apc53pro/Nano-20K-GPU/docs/images/current-gpu-pipeline.pdf

# Current GPU model — shared-reciprocal textured pipeline N20K-SYS-0.1 — host, ordered execution, shared SDRAM and independent scanout

Host CPU / driver — outside simulated GPU execution time

### Current device model — one common 100.8 MHz core / SDR clock (configured assumption)

Clocked host interface — no direct C++ pass injection

Ordered executor — exactly one command operation active; branches are alternatives

Shared memory subsystem — six bounded client ports, one physical SDR data bus

Independent scanout — continues while the ordered executor renders or waits

Transform and homogeneous clipping Projection / Q4 triangle setup / lighting Stable bins for 300 logical 32×32 tiles

HostPassCompiler / CPU packet encoder Persistent images + 320-byte prepared records Tile table + ordered address lists Upload new/changed textures + transient heap Typical stream: WRITE_HEAP, SUBMIT_PASS, then separate FENCE and PRESENT commands prepared commands and pixels

Shared 8-bit parallel bus
25.2 MHz derived transfer cadence ≤1 byte / 4 core edges, one direction Setup 1 / hold 1 core cycle Register select + valid/read/ready

serialized request bytes

RX FIFO: 256 bytes
1 × SDPB 1024×16
Low byte per native word

accepted write byte

Sideband reads bypass command queue Regs 1–63: coherent status snapshot Regs 64–127: immutable capabilities Status remains readable during faults

read selector

Out-of-band abort / reset
Abort: quiesce, drain issued memory, flush queues, new epoch
Reset: restart initialization

out-of-band controls

Byte parser / protocol checks 16-byte NGPU header, version 0.1 Length ≤1024, opcode and sequence Partial packets never execute

registered read / capture

3 × 1024-byte packet banks 3 × SDPB 1024×16
2 published command slots
INCLUDING the active front lease + 1 decoder-owned staging bank

write staged payload
publish only complete packet | Synchronous payload read port
| Executor holds front-bank ownership
| until that command retires

front-bank lease

SystemModel executor FSM
Capture payload through packet RAM Validate ranges / attachment ownership Select one operation; retain its lease

latched request fields

fresh packet boundary | snapshot / capability byte

cancel / drain / recover

Reply construction / serializer
1 × SDPB 1024×16
1 byte write / core edge
Separate synchronous read / capture Reply: sequence + epoch + token

TX reply FIFO: 1024 bytes
1 × SDPB 1024×16
Registered RAM + byte prefetch Host pauses propagate backpressure

registered reply byte

Command retirement
Release front packet bank
Advance ordered command stream

reply published to TX

reply-byte read

established status GET_CAPS / GET_STATUS reply

WRITE_HEAP
Writer: one 32-bit pack + 4-bit mask Source ≤1 byte / core edge Uploads cannot write attachments

opcode 3

SUBMIT_PASS
One-record lookahead during current draw One resident + one completed tile One-edge bank-role exchange; no pixel copy CLEAR export overlaps next tile; LOAD serialized 14 rendering banks +3 existing staging banks

opcode 4

COPY_RECT / heap-image copy Outside a render pass
Full clipped row, ≤640 RGB565 pixels Reuse texture-cache bank as scratch Row direction preserves overlap

opcode 5

READ_MEMORY
Ordered read, length 1–512 bytes Uses timed shared reader
No dirty-tile inspection shortcut

opcode 8

FENCE
Execute after earlier stores complete Publish host token / sequence / epoch

opcode 6

PRESENT
Seal initialized writable target Wait for eligible vertical blank Swap front; then publish completion

opcode 7

write acknowledgements

Host client
Heap upload writes

timed upload

final tile stores acknowledged

Resource alias, not another RAM 1 × SDPB 1024×16
Texture cache OR copy-row scratch Mutually exclusive owners

texture owner

Command client
Descriptor / table / reference / record Diagnostic READ_MEMORY
Slot-read stream directly captures record fields

fetch prepared work

Tile client
Attachment boot writes
Color / depth loads and stores

attachment transfers

Texture client
External cache refill reads

cache miss only

Host-only cycle observer / throughput scoreboard Distinct accept and retire IDs; stage / enable / occupancy Common-clock CSV traces and cadence / latency histograms Adds no GPU registers, queues or ports

per-edge observations

destination writes acknowledged | copy owner; invalidate tags

Copy client
Source reads / masked destination writes

timed color copy

address + length + data

timed read

completion completion after swap

Front / back ownership
Front is read-only to draws / copies Old front becomes back after swap

swap only at vblank

next complete command

Per-client ownership / backpressure 1 request or unconsumed response slot 1–16 × 32-bit words, ≤64 bytes
2 × SDPB 1024×16 per client: 12 banks Shared write-request / read-response data Word-fill + synchronous read ports Held response keeps its slot occupied

Scanout client
Current front-buffer reads

Request arbitration
Scanout priority quota ≤4 requests when other clients are waiting Other five clients round-robin One active request runs to completion

queued request / response

Clocked SDRAM controller / native pins Open rows / bank selection / ACTIVATE PRECHARGE / CAS / write recovery Read↔write turnaround / DQM masks Sequential native BL8 (32-byte bursts) Short / unaligned requests still pay BL8 grant / registered completion

Initialization and mandatory refresh ≥100 µs wait → PRECHARGE → 2 refreshes → MODE / timing waits Refresh deadline ≤15.625 µs ≤1575 cycles at 100.8 MHz
Worst-case request / precharge guard

reserve service before deadline

Embedded SDR SDRAM: 8 MiB, x32 4 banks ×2048 rows ×256 columns 403.2 MB/s raw peak at 100.8 MHz
Word mapping: row11 | bank2 | col8
2 × RGB565 color + shared D24/U32 Heap: textures / records / descriptors / bins command / address / x32 DQ beats

Free-running display timing
H: 640 +16 front +96 sync +48 back V: 480 +10 front +2 sync +33 back Startup stays black until valid memory

Front-buffer prefetch
1 outstanding tagged SDRAM read Owned slot: synchronous 32-bit reads One 32-bit hold → two RGB565 writes Stale responses discarded at swap

current physical color ID

request / response

RGB565 display FIFO: 2048 pixels 2 × SDPB 1024×16
Synchronous read → later capture Smaller limits are stress settings one RGB565 write / edge; slot-read bubbles

Pixel consumer: core / 4 =25.2 MHz 640×480 active, 800×525 total 60 Hz, negative H/V sync
Underflow: black rest of frame Resynchronize at vertical blank

old registered output

Host-only observer
SDL / S-key screenshot show actual FIFO output Raw dumps inspect completed framebuffer Observer images are not GPU memory captured completed scanout frame established vertical-blank pulse

pixel enable / H / V

Limits that matter
Pipelined fragments, record lookahead and completed CLEAR-tile export overlap One active ordered command; heap uploads remain serialized
CPU wide validation checks are simulation assertions, not timed GPU units 39 native BSRAM =14 renderer +25 system I/O and staging 46 of48 native18×18 DSP equivalents; 64 textured contexts; bounded registers / logic ROM Whole-system LUT / FF fit and achieved clock remain unproven Solid teal: data / request-response. Dashed blue: control. Dotted purple: shared resource. HDMI/TMDS signaling excluded.

# Current GPU renderer — shared reciprocal and streaming fragments N20K-HW-RENDER-0.3 · bounded contexts, backpressure and ordered retirement

## 1 · Primitive capture, setup and sample generation

## 2 · Separate untextured and textured paths

## 3 · Shared-reciprocal U/V pipeline — initiation interval ONE

## 4 · Streaming texture hit path — initiation interval ONE, at most eight reservations

## 5 · Raw key test and parallel RGB shading — initiation interval ONE

## 6 · Ordered completion and attachment commit

Immutable prepared primitive
1 capture edge; bind texture CPU clipping / triangle setup external Drain before next primitive

Triangle initialization
6 products ×4 edges =24
ONE dedicated setup MULT18X18 Exact Δy + Δx plane-anchor walk

Covered candidate:
texture needed?

Triangle / 2D walker
Q4 centers and top-left coverage Signed32 edges; signed64 planes Rect / sprite grid; global line walk
At most one candidate / edge Outside coverage: advance without token

covered candidate

Untextured fast path
ONE pending fragment
Depth read → next-edge compare / commit Can retire N while accepting N+1 Same-address depth forwarding

no

Textured context allocation 64-entry ordered ring / six-bit tag Commit address + D24; RGB factor Stop walker when credits unavailable

yes

Why no depth retest at retirement? Each supported primitive visits a pixel once. Primitives drain before another begins. Future primitive overlap needs a hazard policy.

Resident32×32 tile
THREE SDPB1024×16 banks
RGB565 / depth low16 / depth high8 Unused high-depth bits remain zero

enabled writes

Early D24
Native read at acceptance
Compare on following edge
Reject before UV / sampling

HOST-ONLY OBSERVATION
Per-edge accepted and retired tokens; batch cancellation during reset/recovery Walker phase is not exclusive utilization of concurrent arithmetic/cache/shading blocks Hardware activity counters overlap: do not sum them into elapsed clocks System last_pass_cycles includes record fetch, tile DMA, drawing and memory waits Trace IDs, scoreboards and CSV/JSON create no FPGA state or GPU memory ports

Normalize q and signed U/V Carry six-bit context tag
q raw domain [2^29, 2^37]
Sprites bypass this entire stage pass / disabled, textured triangle

Address coordinates
Triangle: signedQ16 floor / clamp / repeat Sprite: existing integer source X/Y Preserve clipped source origin

pass / disabled, sprite

Bounded ready/reason registers
64 ready bits +64 ×2-bit reasons Commit / depth reject / key reject
A younger ready entry waits for older work

depth rejection

Synchronous linear seed ROM 256 entries
35-bit base: THREE native banks 16-bit gradient: ONE native bank

Refine one reciprocal for U and V Registered native18×18 partial products 40 DSP equivalents across full UV unit No assumed free wide multiply

Bounded exact quotient correction SignedQ16 round-to-nearest-even Both U/V and error flags + context tag 26 enabled unit edges TOTAL Parent captures on following edge

Synchronous RGB-factor handoff TWO SDPB banks, 64 ×RGB888 Read context tag → later capture Two elastic coordinate/factor stages

Miss service / replay
Freeze younger address and DSP stages Older cache results drain in order System: one owned Texture SDRAM slot Sync32-bit reads → one held word Two16-bit native writes per word Pad final short-line tail without extra reads

Pitched word address
y × (pitch_low17 + pitch_high ×2^17) + x TWO native registered18×18 DSPs Separate address / tag registers

Matching texture-context FIFO 8 bounded register entries Six-bit tag +24-bit RGB factor Retain until ordered texture output captured with texture request

Tag and synchronous cache read ONE SDPB1024×16 bank
64 direct-mapped lines ×16 texels Native B read → later output capture 7 enabled unit edges on hit TOTAL Parent captures on following edge

miss

Raw RGB565
key match?
old registered texel | pop matching context

line valid; replay held request

Replace or RGB modulation
THREE parallel registered18×18 DSPs 3 unit edges + parent capture Exact rounded /255 shift-add Sprites / replacement use factor255 through the same RGB stages

keep

key rejection

Store RGB565 result
ONE native context-result bank Result +ready update on one edge Scheduler sees OLD ready flags Independent color/depth write controls

next-edge retirement scheduler

matching RGB factor

Retirement context ports
THREE commit-metadata SDPB banks Tile address10 +D24, 64 entries
ONE RGB565 result bank, shared with shade Synchronous read → separate capture

SELECTED RESOURCES / CLOCK QUALIFICATION Renderer:14 BSRAM =3 tile +1 cache/copy +6 context +4 seed ROM System:39 of46 BSRAM =renderer14 +2 scanout +5 host +1 reply +12 client slots +2 reader +3 row 46 of48 native18×18 equivalents =1 setup +40 UV +2 texture address +3 RGB The selected schedule permits overlap; misses/backpressure/context exhaustion cause bubbles. Core/SDRAM100.8MHz is a configurable assumption. Whole-GPU fit and achieved timing are not established. Old serial divider /14-edge texture-hit APIs remain standalone oracles, outside selected GPU execution.

Retire oldest fragment once Conditional RGB565 and D24 writes Rejects write neither attachment Release context credit
One retirement may overlap acceptance release oldest context early native read

# Current GPU model — overlapped tile export and geometry lookahead N20K-SYS-0.1 — exact native ports, ordered commands and shared SDRAM

Command fetch — SDRAM records, one shared Reader and bounded fields

Initialize one resident rendering tile

Primitive loop — current draw and one-record lookahead run concurrently

Completed-tile export — all color and depth values persist by pass completion

Shared memory controller — six owned native slots, one physical SDR bus

Other operations and independently advancing display

Ordered SUBMIT_PASS
Descriptor address from packet RAM Front / sealed targets cannot be written Invalidate texture tags for newly uploaded contents

Fetch 32-byte pass descriptor Target, independent CLEAR/LOAD flags Clear RGB565 / D24 and tile-table address Require initialized attachments for LOAD

start pass

For tile 0…299: fetch 8-byte table entry {list address, reference count}
20 columns ×15 rows of logical 32×32 tiles Empty bins still resolve both attachments

captured fields

Reader: 2 ×SDPB1024×16, x32 port 512-byte payload + alignment guard Pipeline synchronous controller-slot reads Same established word enters RAM + fields ≤320-byte decoded-field register bank READ_MEMORY later streams native RAM reads

32 / 8 byte reads

Resolve independent load operations CLEAR: write constants into resident ports LOAD: per row fetch color 64 B / depth 128 B Unpack through synchronous staging writes Prime + 32 resident writes per loaded row

next tile

Host / Command / Tile / Texture / Copy / Scanout One owned ≤16-word x32 slot per client Two native x16 banks each: 12 total Write requests / read responses share storage One synchronous word port per direction Held response blocks slot reuse

Command / Tile reads

Tile-client LOAD reads

Two physical bank sets; 3 native banks each Each set: RGB56516 / depth-low16 / high8 Each bank: SDPB1024×16, 1024 addresses One read + one write per bank / edge Same-address simultaneous R/W forbidden Role selector routes ports; no pixel-array copy resident-role native writes

Fetch next 4-byte primitive address Then its 320-byte record
Reference order preserved
One reference lookahead, no record cache Record refetched for each tile reference

tile initialized

Both attachments CLEAR?

empty bin

Word-wide tile source through native ports Color: two 16-bit pixel reads per 32-bit word Depth: parallel low/high read → D24/U32 word 32-bit output hold + 16-bit color-half register One staged 32-bit client word / eligible edge No byte-serialization array selected export / resident B ports

Command reads

Capture next primitive only after prior drain Coverage / interpolation / D24 Shared-reciprocal U/V / streaming cache / RGB 64 bounded fragment contexts Current primitive owns captured tile registers first or ready prefetched fields

Texture cache / copy scratch: 1 native bank 2 KiB, 64 lines ×16 RGB565 words
One outstanding miss; younger lookups held Refill one halfword / edge Next slot read overlaps current low-half write depth reads / conditional commits

While current primitive draws: Reader + field bank fetch following record 32-bit address + 2-bit state +invalid flag No second record RAM or decoded-field bank Decode/fault transition after current draw drains

next reference exists

registered lookup / texel

all references drained

fetch concurrently

Texture refill

Wait for previous export to release its banks Exchange resident/export roles on one edge 1024 pixels published by port routing No 1024-pixel memory copy

yes

Background export of completed bank set Next tile initializes and draws in other set Three existing staging banks now use 1024 words No additional BSRAM or DSP

Either attachment LOAD:
Keep load / draw / store serialized Staging used for 32-pixel LOAD rows Store reads resident bank ports directly

no

export-role ports

More tiles?

resident role free immediately staged native reads

resident native reads

For each of 32 rows:
Color 64 B, depth-low-half 64 B, high-half 64 B 16-word client fill →publish →write ACK One owned Tile slot; backpressure retained

32-bit words

LOAD: after tile ACK

Final export acknowledged
Mark target color + shared depth valid Retire SUBMIT_PASS; FENCE may complete PRESENT separately waits for vertical blank

last tile ACK

Tile writes / ACK

yes

no: wait for final ACK

Independent FRONT-only scanout Scanout slot synchronous 32-bit reads One 32-bit hold → two RGB565 FIFO writes 2048-pixel FIFO: 2 native banks 25.2 MHz pixels / 800×525 totals / 60 Hz Underflow blanks until next vertical blank PRESENT swaps only at vertical blank

later PRESENT

One active transaction
Scanout quota ≤4 grants while others wait Other clients round-robin
Refresh guard reserves worst-case service Default deadline ≤1575 core edges

Ordered WRITE_HEAP commands Clocked 8-bit packet source / 32-bit pack Execute after earlier pass releases resources CPU keeps unchanged textures resident No asynchronous upload-write bypass

Common core/SDR clock: 100.8 MHz assumption CL3, tRP/RCD/WR/MRD 3, tRFC 9 tRAS 6, tRC 9, turnarounds 2 Sequential aligned BL8 x32 physical bursts Short/unaligned requests still pay BL8 DQM masks padding writes

Embedded SDR SDRAM: 8 MiB, x32 4 banks ×2048 rows ×256 columns Color 0: 0x000000, color 1: 0x096000 D24/U32: 0x12C000
Heap: 0x258000…0x7FFFFF
403.2 MB/s raw peak at assumed 100.8 MHz

native commands / DQ

Host client

COPY_RECT outside passes
Reuse cache bank as ≤640-pixel row scratch Read entire row before writing it Choose safe forward/reverse row order Depth unchanged; texture tags invalidated

Traffic / accounting
Each pass stores 1,843,200 useful color+depth bytes; LOAD of both adds 1,843,200 read bytes Boot explicitly writes 2,457,600 attachment bytes; exclude boot when measuring steady-state submissions 39 native BSRAM = 14 renderer + 25 system; 46/48 native 18×18 DSP equivalents
One resident +one completed tile use two existing three-bank sets selected by a role mux Eight 64-bit optimization counters; bounded lookahead/export controls; no hidden record payload storage Fit and achieved clock unproven; model FPS is not measured FPGA performance Host observers, CPU texture snapshots and diagnostics add no GPU memory ports Solid teal: data. Dashed blue: control. Dotted purple: shared resource. HDMI signaling excluded.

exclusive scratch owner

Copy client Scanout client
