apc53pro/Nano-20K-GPU/docs/images/opaque-hardware-model.png

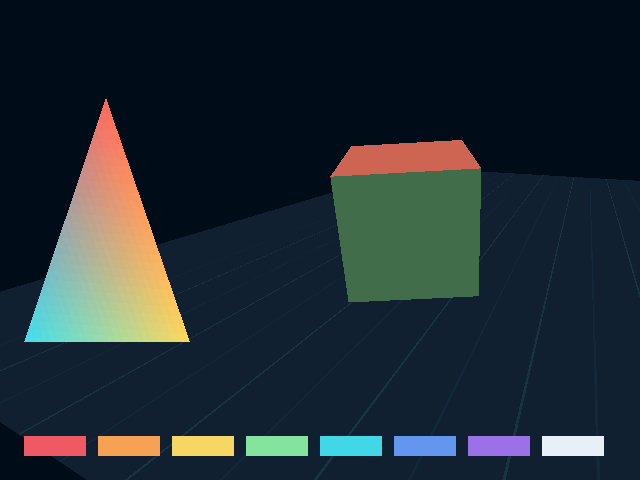
docs/images/opaque-hardware-model.png
