apc53pro/Nano-20K-GPU/rtl/gpu/nano_gpu_core.sv

// Functional command-to-pixel RTL core. The initial implementation serializes
// tile transfers; it is the actual circuit simulated by Verilator and synthesized.
// External SDRAM is accessed only through nano_sdram_service's physical pins.
module nano_gpu_core #(
    parameter integer POWERUP_CYCLES = 10080,
    parameter integer REFRESH_INTERVAL = 1575,
    parameter integer SDRAM_CAS_LATENCY = 3,
    parameter integer SDRAM_T_RP = 3,
    parameter integer SDRAM_T_RCD = 3,
    parameter integer SDRAM_T_RFC = 9,
    parameter integer SDRAM_T_MRD = 3,
    parameter integer SDRAM_T_WR = 3,
    parameter integer SDRAM_T_RAS = 6,
    parameter integer SDRAM_T_RC = 9,
    parameter integer SDRAM_READ_TO_WRITE = 2,
    parameter integer SDRAM_WRITE_TO_READ = 2,
    parameter integer CORE_HZ = 100800000,
    parameter integer HOST_DIVIDER_METADATA = 4,
    parameter integer PIXEL_DIVIDER = 4,
    parameter integer EXTERNAL_PIXEL_TICK = 0
)(
    input wire clk, input wire reset, input wire host_clk, input wire abort_request,
    input wire pixel_advance,
    input wire host_wr_valid, input wire [7:0] host_wr_data,
    output wire host_wr_ready, output wire host_wr_ready_base,
    input wire host_rd_req, input wire [6:0] host_reg_addr,
    output wire [7:0] host_rd_data, output wire host_rd_valid,
    input wire [31:0] sd_dq_in,
    output wire sd_clk, output wire sd_cke, output wire sd_cs_n,
    output wire sd_ras_n, output wire sd_cas_n, output wire sd_we_n,
    output wire [1:0] sd_ba, output wire [10:0] sd_addr,
    output wire [31:0] sd_dq_out, output wire sd_dq_oe, output wire [3:0] sd_dqm,
    output wire [15:0] video_rgb565, output wire video_hsync,
    output wire video_vsync, output wire video_de,
    output wire [9:0] video_x, output wire [8:0] video_y,
    output reg video_pixel_ce,
    output wire busy, output wire ready, output wire fault,
    output reg [7:0] fault_code
);
    localparam [22:0] COLOR_BYTES=23'd614400, DEPTH_BASE=23'h12c000,
        HEAP_BASE=23'h258000;
    localparam [31:0] MEMORY_BYTES=32'h00800000;
    localparam [7:0] S_BOOT_WAIT=0, S_BOOT_CMD=1, S_BOOT_DATA=2, S_BOOT_DONE=3,
        S_IDLE=4, S_CAPTURE_REQ=5, S_CAPTURE_WAIT=6, S_EXECUTE=7,
        S_UPLOAD_PREP=8, S_UPLOAD_CMD=9, S_UPLOAD_NEXT=10,
        S_UPLOAD_EMIT=11, S_UPLOAD_WORD=12, S_UPLOAD_DONE=13,
        S_DESC_CMD=14, S_DESC_DATA=15, S_DESC_DONE=16,
        S_ENTRY_CMD=17, S_ENTRY_DATA=18, S_ENTRY_DONE=19,
        S_TILE_INIT=20, S_LOAD_CMD=21, S_LOAD_DATA=22, S_LOAD_DONE=23,
        S_PASS_DRAIN=24,
        S_REF_CMD=28, S_REF_DATA=29, S_REF_DONE=30,
        S_RECORD_CMD=31, S_RECORD_DATA=32, S_RECORD_DONE=33,
        S_DRAW_START=34, S_DRAW_WAIT=35,
        S_STORE_CMD=36, S_STORE_PREFETCH=37, S_STORE_HIGH=38,
        S_STORE_WORD=41, S_STORE_DONE=42,
        S_REPLY=44, S_REPLY_RAM_REQ=45, S_REPLY_RAM_WAIT=46,
        S_READ_CMD=47, S_READ_DATA=48, S_READ_BYTES=49, S_READ_DONE=50,
        S_COPY_VALIDATE=51, S_COPY_INIT_ADDR=52,
        S_COPY_READ_CMD=53, S_COPY_READ_DATA=54, S_COPY_READ_DONE=55,
        S_COPY_PREFETCH=56, S_COPY_FLUSH=57, S_COPY_WRITE_CMD=58,
        S_COPY_WRITE_DATA=59, S_COPY_WRITE_DONE=60,
        S_FAULT=61, S_RECOVER=62,
        S_UPLOAD_STAGE_LOW=63, S_UPLOAD_STAGE_HIGH=64,
        S_UPLOAD_RAM_LOW=65, S_UPLOAD_RAM_HIGH=66, S_COPY_CLIP=67,
        S_COPY_FETCH_REQ=68, S_COPY_FETCH_WAIT=69, S_COPY_CLIP_CHECK=70,
        S_UPLOAD_STAGE_MASK=71, S_UPLOAD_RAM_MASK=72,
        S_UPLOAD_HEADER_REQ=73, S_UPLOAD_HEADER_WAIT=74,
        S_UPLOAD_CODE=75, S_UPLOAD_CODE_REQ=76, S_UPLOAD_CODE_WAIT=77,
        S_COPY_INIT_PREP=78, S_SETUP=79, S_COPY_CLIP_CMP=80;
    reg [7:0] state /*verilator public_flat_rd*/;
    reg initialized, front_id, sealed, depth_valid, pass_active, copy_active;
    // Overlapped PRESENT. The command is accepted at once and its target
    // sealed; the swap still happens at vertical blank. Meanwhile only
    // WRITE_HEAP commands execute; every other command waits for the swap
    // and for the PRESENT reply, which is sent when the executor is next idle
    // so replies stay in command order. reply_token holds the PRESENT token
    // until then (no reply is started while the swap is pending).
    reg present_wait, present_reply_due, present_reply;
    reg [31:0] present_sequence;
    reg [1:0] color_valid;
    reg [31:0] epoch, completed_sequence, fence_token, present_token;
    // 48 physical bits span >64 days at the board clock; the wire slot is u64.
    reg [47:0] cycle_counter;
    localparam integer PIXEL_PHASE_BITS = $clog2(PIXEL_DIVIDER);
    reg [PIXEL_PHASE_BITS-1:0] pixel_phase;
    wire pixel_tick = EXTERNAL_PIXEL_TICK ? pixel_advance : &pixel_phase;
    reg abort_sync1, abort_sync2, abort_previous, abort_pending, fault_pending;
    reg foreground_quiet;
    reg renderer_reset, host_abort;
    reg [5:0] pending_memory;

    wire [5:0] mem_cmd_ready, mem_w_ready, mem_r_valid, mem_r_last, mem_done, mem_error;
    wire [191:0] mem_r_data;
    reg [5:0] mem_cmd_valid, mem_cmd_write, mem_w_valid, mem_r_ready;
    // Tile stores (client 3) do not wait for each burst: the SDRAM service
    // releases its command slot early, so the next row's burst is requested
    // while the previous one finishes. At most two client-3 transactions are
    // in flight; this count replaces its single pending_memory bit. A tile
    // LOAD waits for it to reach zero, so mem_done[3] in S_LOAD_DONE is the
    // load's own, and a pass completes only after its stores (S_PASS_DRAIN).
    reg [1:0] mem3_outstanding;
    wire [1:0] mem3_next = mem3_outstanding + {1'b0, mem_cmd_valid[3] && mem_cmd_ready[3]} -
        {1'b0, mem_done[3]};
    reg [137:0] mem_cmd_addr;
    reg [29:0] mem_cmd_words;
    reg [191:0] mem_w_data;
    reg [23:0] mem_w_strb;
    wire memory_initialized;
    // Recovery first registers that all foreground command ports are quiet.
    // A transaction accepted on that entry edge is recorded by pending_memory
    // before a later edge may reset its client. This keeps the SDRAM arbiter's
    // combinational ready path out of the controller's recovery decision.

    wire host_cmd_valid, payload_valid, response_ready, host_recovering;
    wire [15:0] host_cmd_opcode;
    wire [31:0] host_cmd_sequence;
    wire [10:0] host_cmd_length;
    wire [7:0] payload_data, host_fault;
    assign ready = initialized && !host_recovering;
    assign fault = fault_pending || state == S_FAULT;
    // A PRESENT waiting for its swap or reply keeps the core busy, as before.
    assign busy = !ready || state != S_IDLE || host_cmd_valid || present_wait || present_reply_due;
    reg host_cmd_pop, payload_req, response_valid;
    reg [9:0] payload_offset;
    reg [7:0] response_data;
    reg [511:0] status_snapshot, capabilities;
    // Native packet metadata stays immutable at the queue head until the
    // command retires and cmd_pop is consumed. No duplicate header FF bank is
    // needed; recovery abandons the command before flushing its lease.
    wire [15:0] opcode = host_cmd_opcode;
    wire [31:0] command_sequence = host_cmd_sequence;
    wire [10:0] payload_length = host_cmd_length;
    // The native host packet bank retains the complete payload until command
    // retirement. Decode one u32 at a time instead of copying a 56-byte prefix.
    reg [31:0] packet_word;
    wire [31:0] capture_word_data = {payload_data,packet_word[31:8]};
    reg capture_invalid, copy_command_invalid;
    reg [5:0] capture_index, capture_length;

    wire scan_cmd_valid, scan_cmd_write, scan_r_ready;
    wire [22:0] scan_cmd_addr;
    wire [4:0] scan_cmd_words;
    wire [31:0] scanout_underflows;
    wire vblank_pulse;
    wire tex_cmd_valid, tex_cmd_write, tex_w_valid, tex_r_ready;
    wire [22:0] tex_cmd_addr;
    wire [4:0] tex_cmd_words;
    wire [31:0] tex_w_data;
    wire [3:0] tex_w_strb;
    wire tex_cfg_valid, tex_cfg_ready, tex_cfg_repeat_u, tex_cfg_repeat_v;
    wire [22:0] tex_cfg_base, tex_cfg_pitch;
    wire [10:0] tex_cfg_width, tex_cfg_height;
    wire tex_req_valid, tex_req_ready, tex_rsp_valid, tex_rsp_ready, tex_fault;
    wire signed [31:0] tex_req_x, tex_req_y;
    wire [5:0] tex_req_tag, tex_rsp_tag;
    wire [15:0] tex_rsp_texel;
    reg tex_flush;

    reg tile_cmd_word_we, tile_cmd_valid, tile_pix_re;
    reg [1:0] tile_pix_we; // {depth, color}
    reg [6:0] tile_cmd_word_index;
    reg [31:0] tile_cmd_word_data;
    reg record_load_valid;
    reg [6:0] record_load_index;
    reg [31:0] record_load_data;
    // Kind-4 vertex-triangle setup (nano_triangle_setup).
    reg setup_started;
    reg record_long_bad, last_reference;   // registered at S_REF_DATA
    wire setup_vertex, setup_done, setup_draw, setup_bad, setup_word_we;
    wire [6:0] setup_word_index;
    wire [31:0] setup_word_data;
    wire tile_cmd_ready, tile_busy, tile_done, tile_fault, tile_pix_rvalid;
    reg [9:0] tile_pix_addr, tile_pix_raddr;
    reg [15:0] tile_pix_color;
    reg [23:0] tile_pix_depth;
    wire [15:0] tile_pix_rcolor;
    wire [23:0] tile_pix_rdepth;

    reg descriptor_invalid;
    reg target_id, clear_color_enable, clear_depth_enable, depth_discard;
    // Load-flag bit 3: tiles without references keep their SDRAM contents
    // (no clear, load or store). depth_keep is the depth validity at pass
    // start, which untouched tiles retain.
    reg skip_empty, depth_keep;
    reg [15:0] clear_color;
    reg [23:0] clear_depth;
    reg [22:0] table_address, list_address, record_address;
    reg [20:0] reference_count, reference_index, references_seen;
    reg [4:0] tile_x_index;
    reg [3:0] tile_y_index;
    wire [9:0] tile_origin_x = {tile_x_index,5'b0};
    wire [8:0] tile_origin_y = {tile_y_index,5'b0};
    reg [8:0] tile_index;
    reg [9:0] pixel_index;
    reg [6:0] record_word;
    reg [4:0] beat;
    reg [4:0] row;
    // Tile attachment transfers walk rows; each row moves one 16-word color
    // burst (kind 0) and two 16-word depth bursts (kinds 1, 2) as enabled.
    // A constant store writes clear values for a tile without draws and
    // never reads tile RAM. load_half selects the second pixel of a color word.
    reg [1:0] store_kind;
    reg xfer_color, xfer_depth, store_constant, load_half;
    // The tile write port is idle during STORE: each pixel read for a store
    // is rewritten with its attachment's clear value on the next edge. After
    // a tile with draws, every cleared attachment already holds its clear
    // value (tile_ram_clear), so later tiles of the pass skip TILE_INIT.
    // Depth is cleared when it is read for its own store, or with color when
    // depth is discarded.
    reg tile_ram_clear, clear_back_valid;
    reg [1:0] clear_back_we;
    reg [9:0] clear_back_addr;
    wire clear_back_color = store_kind==0 && clear_color_enable;
    wire clear_back_depth = clear_depth_enable && (store_kind!=0 || depth_discard);
    wire xfer_last = row==31 && (store_kind==2 || (store_kind==0 && !xfer_depth));
    reg [15:0] held_color;
    reg [31:0] packed_word;
    reg [22:0] boot_address;

    reg [22:0] upload_address;
    reg [10:0] upload_length, upload_cursor;
    reg [6:0] upload_chunk, upload_fill;
    reg [1:0] upload_prefix;
    reg [4:0] upload_words;
    // Sole upload representation: one descriptor byte for four little-endian
    // words, then zero/signed8/signed16/raw32 payloads. The command capture
    // register packet_word becomes the decoded-word shift register. Uploads
    // reuse read_cursor as the encoded-body cursor, read_lane as the decoded
    // byte index and capture_index as the literal-byte counter; those clients
    // cannot execute concurrently. No second word buffer or decoder instance.
    reg [7:0] upload_descriptor;
    wire [1:0] upload_code = upload_descriptor[1:0];
    wire [1:0] upload_literal_last = upload_code==3 ? 2'd3 :
        (upload_code==2 ? 2'd1 : 2'd0);
    wire [3:0] upload_group_offset = upload_cursor[3:0] + upload_fill[3:0];
    reg [3:0] packed_mask;
    wire [22:0] upload_current = upload_address + {12'd0,upload_cursor};
    wire [10:0] upload_remaining = upload_length - upload_cursor;
    wire [6:0] upload_room = 7'd64 - {5'd0,upload_current[1:0]};
    wire [6:0] upload_next_chunk = upload_remaining > {4'd0,upload_room} ?
        upload_room : upload_remaining[6:0];
    wire [6:0] upload_rounded_bytes = {5'd0,upload_current[1:0]} + upload_next_chunk + 7'd3;
    wire [1:0] upload_lane = (upload_prefix + upload_fill) & 2'b11;
    // Finish fetching a bounded host chunk before reserving the shared SDRAM
    // service. Slow byte reads must never hold its sole transaction owner and
    // starve the independent display FIFO. One native bank stores the sixteen
    // u32 payload words as pairs of u16. Their four-bit masks occupy unused
    // native words32..47, avoiding a duplicated64-bit register/mux bank.
    reg upload_ram_we, upload_ram_re;
    reg [9:0] upload_ram_waddr, upload_ram_raddr;
    reg [15:0] upload_ram_wdata;
    wire [15:0] upload_ram_rdata;

    reg [22:0] read_address;
    reg [9:0] read_length, read_cursor;
    reg [22:0] read_next_address;
    reg [7:0] read_words_remaining;
    reg [4:0] read_burst_words;
    reg [31:0] read_word_hold;
    reg [1:0] read_lane;
    // The upload path also reuses read_length for the encoded body extent.
    // Literal sign extension is generated one emitted byte at a time, keeping
    // the shared 32-bit capture register on its existing shift datapath.
    wire upload_encoded_available = read_cursor < read_length;
    wire upload_final_byte = upload_remaining == {4'd0,upload_fill} + 11'd1;
    wire [7:0] upload_decoded_byte = upload_code==0 ? 8'd0 :
        upload_code==1 ? (read_lane==0 ? packet_word[31:24] : {8{packet_word[31]}}) :
        upload_code==2 ? (read_lane==0 ? packet_word[23:16] :
            (read_lane==1 ? packet_word[31:24] : {8{packet_word[31]}})) : packet_word[7:0];
    // Full request bounds are checked before these narrowed transfer counters
    // are used. A read of 1..512 bytes spans at most 129 aligned u32 words.
    wire [9:0] read_initial_rounded = read_length + {8'd0,read_address[1:0]} + 10'd3;
    wire [7:0] read_initial_words = read_initial_rounded[9:2];
    wire [7:0] read_words_after_burst = read_words_remaining - {3'd0,read_burst_words};
    reg read_first, read_done_hold;
    reg [10:0] reply_index, reply_length;
    reg [31:0] reply_token;
    reg reply_caps;
    reg [47:0] reply_cycle_snapshot;
    reg [31:0] reply_underflow_snapshot;
    reg [7:0] reply_flags_snapshot, reply_host_fault_snapshot;
    reg reply_has_snapshot, reply_has_readback;
    wire [10:0] reply_payload_bytes = reply_length - 11'd16;
    reg [7:0] reply_data_hold;
    reg reply_ram_we, reply_ram_re;
    reg [9:0] reply_ram_waddr, reply_ram_raddr;
    reg [15:0] reply_ram_wdata;
    wire [15:0] reply_ram_rdata;

    reg copy_source_kind, copy_source_id, copy_target_id;
    reg copy_reverse;
    reg copy_previous_valid;
    reg [22:0] copy_base, copy_pitch;
    reg [10:0] copy_image_width, copy_image_height;
    reg [22:0] copy_source_row, copy_destination_row;
    reg signed [32:0] copy_low, copy_high;
    reg [3:0] copy_setup_step;
    wire copy_clip_minimum = copy_setup_step==3 || copy_setup_step==4 ||
        copy_setup_step==10 || copy_setup_step==11;
    wire signed [32:0] copy_raw_coordinate = {packet_word[31],packet_word};
    reg signed [32:0] copy_clip_left, copy_clip_right, copy_clip_bound;
    wire signed [32:0] copy_clip_candidate = copy_clip_left - copy_clip_right;
    // The candidate is registered before it is compared: one subtract and one
    // compare per clock, one extra clock per interval step.
    reg signed [32:0] copy_clip_held;
    wire copy_clip_less = copy_clip_held < copy_clip_bound;
    wire copy_clip_equal = copy_clip_held == copy_clip_bound;
    wire copy_clip_better = copy_clip_minimum ? copy_clip_less :
        !(copy_clip_less || copy_clip_equal);
    reg [10:0] copy_count_x, copy_count_y, copy_row_number;
    reg [10:0] copy_address_steps, copy_extent_steps;
    reg [23:0] copy_extent_address;
    // Burst row copy. Each row is read as whole 32-bit source words in bursts
    // of up to 16, realigned on arrival into destination-aligned words held
    // in one 512x32 native row RAM, then written back in bursts of up to 16
    // with per-word half strobes. The whole row is read before any of it is
    // written, so a same-row overlap cannot read already-written pixels.
    reg [9:0] copy_word, copy_burst_end, copy_comp;
    reg [31:0] copy_prev;
    reg copy_ram_we, copy_ram_re;
    reg [8:0] copy_ram_waddr, copy_ram_raddr;
    reg [31:0] copy_ram_wdata;
    wire [31:0] copy_ram_rdata;
    wire copy_src_off = copy_source_row[1], copy_dst_off = copy_destination_row[1];
    // A one-pixel source/destination phase difference pairs each source
    // word's low half with the previous word's high half.
    wire copy_shifted = copy_src_off != copy_dst_off;
    wire [11:0] copy_src_span = {1'b0,copy_count_x} + {11'd0,copy_src_off} + 12'd1;
    wire [11:0] copy_dst_span = {1'b0,copy_count_x} + {11'd0,copy_dst_off} + 12'd1;
    wire [9:0] copy_src_words = copy_src_span[10:1];
    wire [9:0] copy_dst_words = copy_dst_span[10:1];
    wire [9:0] copy_read_left = copy_src_words - copy_word;
    wire [9:0] copy_write_left = copy_dst_words - copy_word;
    wire [4:0] copy_read_burst = copy_read_left > 10'd16 ? 5'd16 : copy_read_left[4:0];
    wire [4:0] copy_write_burst = copy_write_left > 10'd16 ? 5'd16 : copy_write_left[4:0];
    wire [31:0] copy_read_word = mem_r_data[5*32 +:32];
    wire [31:0] copy_composed = copy_shifted ? {copy_read_word[15:0],copy_prev[31:16]} : copy_read_word;
    // With source phase 1 and destination phase 0, the first source word only
    // supplies the high half for destination word zero.
    wire copy_skip_compose = copy_src_off && !copy_dst_off && copy_word==0;
    // Destination word w holds row pixels 2w-dst_off (low) and +1 (high).
    // The 12-bit wrap of -1 for word zero falls outside the row by compare.
    wire [11:0] copy_low_pixel = {1'b0,copy_word,1'b0} - {11'd0,copy_dst_off};
    wire copy_low_valid = copy_low_pixel < {1'b0,copy_count_x};
    wire copy_high_valid = (copy_low_pixel + 12'd1) < {1'b0,copy_count_x};

    // These bounded origins are retained only after complete signed clipping.
    // Raw coordinates/extents remain in the owned native packet bank and are
    // re-read when setup needs them, including INT32_MIN/MAX cases.
    reg [10:0] copy_first_source_x, copy_first_source_y;
    reg [9:0] copy_first_destination_x;
    reg [8:0] copy_first_destination_y;
    wire [10:0] copy_source_start_y = copy_first_source_y + copy_row_number;
    wire copy_should_reverse = !copy_source_kind && copy_source_id==copy_target_id &&
        {2'd0,copy_first_destination_y}>copy_first_source_y;
    wire [8:0] copy_last_destination_y = copy_first_destination_y + copy_count_y - 11'd1;
    wire [8:0] copy_destination_start_y = copy_should_reverse ? copy_last_destination_y : copy_first_destination_y;
    // S_COPY_INIT_PREP registers the direction and starting destination row,
    // so the overlap compare/row select and the y*640+x address arithmetic
    // fall in separate core periods.
    reg [8:0] copy_destination_start_y_r;
    wire [18:0] copy_destination_start_pixel = global_pixel(copy_first_destination_x,copy_destination_start_y_r);
    wire [21:0] pass_reference_total = {1'b0,references_seen} + {1'b0,reference_count};

    integer i;
    function automatic [5:0] copy_parameter_offset(input [3:0] step);
        begin
            case(step)
            0: copy_parameter_offset=28; // requested width
            1,3,5: copy_parameter_offset=12; // source X
            2,4,6: copy_parameter_offset=20; // destination X
            7: copy_parameter_offset=32; // requested height
            8,10,12: copy_parameter_offset=16; // source Y
            9,11,13: copy_parameter_offset=24; // destination Y
            default: copy_parameter_offset=0;
            endcase
        end
    endfunction
    function automatic [22:0] color_base(input id);
        color_base = id ? COLOR_BYTES : 23'd0;
    endfunction
    function automatic [22:0] global_pixel(input [9:0] x, input [8:0] y);
        global_pixel = ({14'd0,y} << 9) + ({14'd0,y} << 7) + {13'd0,x};
    endfunction
    function automatic valid_heap(input [31:0] address, input [32:0] length, input aligned);
        // Any accepted range starts above zero, so neither its address nor its
        // length can reach 8 MiB. Reject high bits before the 24-bit sum: two
        // 23-bit operands cannot overflow this checked addition.
        valid_heap = !(|address[31:23]) && address[22:0] >= HEAP_BASE && !(|length[32:23]) &&
                     {1'b0,address[22:0]}+{1'b0,length[22:0]} <= 24'h800000 &&
                     (!aligned || address[1:0] == 0);
    endfunction
    function automatic [7:0] reply_snapshot_byte(input [5:0] index);
        reg [511:0] held_status;
        begin
            // Ordered query execution blocks all foreground state changes.
            // Capture the independently advancing counters and status flags;
            // the remaining fields are stable until this reply retires.
            // Abort/fault abandons an incomplete reply before reusing state.
            held_status=status_snapshot;
            held_status[8 +:8]=reply_flags_snapshot;
            held_status[128 +:64]=reply_cycle_snapshot;
            held_status[192 +:64]={32'd0,reply_underflow_snapshot};
            held_status[448 +:8]=reply_host_fault_snapshot;
            // Serialize each source independently before selecting eight bits;
            // immutable capabilities never need a duplicated snapshot bank.
            if(reply_caps) reply_snapshot_byte=capabilities[{index,3'b0} +:8];
            else reply_snapshot_byte=held_status[{index,3'b0} +:8];
        end
    endfunction
    function automatic [7:0] reply_byte(input [10:0] index);
        reg [31:0] word_value;
        begin
            word_value=0;
            if (index<4) word_value=32'h5550474e;
            else if(index<8) word_value={(present_reply ? 16'd7 : opcode)|16'h8000,8'd2,8'd0};
            else if(index<12) word_value={21'd0,reply_payload_bytes};
            else if(index<16) word_value=present_reply ? present_sequence : command_sequence;
            else if(index<20) word_value=epoch;
            else if(index<24) word_value=0;
            else if(index<28) word_value=reply_token;
            else if(reply_has_readback && index<32) word_value=read_address;
            else if(reply_has_readback && index<36) word_value={22'd0,read_length};
            if(reply_has_snapshot && index>=28 && index<92)
                reply_byte=reply_snapshot_byte(index-11'd28);
            else reply_byte=word_value[(index[1:0])*8 +:8];
        end
    endfunction
    task automatic complete_command;
        begin
            completed_sequence<=command_sequence;
            host_cmd_pop<=1;
            state<=S_IDLE;
        end
    endtask
    task automatic raise_fault(input [7:0] code);
        begin
            if(!fault_pending) fault_code<=code;
            fault_pending<=1;
            if(pass_active) begin color_valid[target_id]<=0; depth_valid<=0; end
            if(copy_active) color_valid[copy_target_id]<=0;
            sealed<=0; present_wait<=0; present_reply_due<=0;
        end
    endtask
    task automatic start_reply(input [31:0] token, input snapshot, input readback);
        begin
            reply_token<=token; reply_has_snapshot<=snapshot; reply_has_readback<=readback;
            reply_length<=readback ? 11'd36+{1'b0,read_length} : (snapshot ? 11'd92 : 11'd28);
            reply_index<=0; state<=S_REPLY;
        end
    endtask
    // After a reference draws (or setup rejects it), fetch the next one or
    // store the tile.
    task automatic finish_reference;
        begin
            if(last_reference) begin
                row<=0; beat<=0; store_kind<=0; store_constant<=0;
                xfer_color<=1; xfer_depth<=!depth_discard; state<=S_STORE_CMD;
            end
            else begin reference_index<=reference_index+1; state<=S_REF_CMD; end
        end
    endtask
    // Advance to the next enabled burst of a tile attachment transfer.
    task automatic next_transfer;
        begin
            if(store_kind==1) store_kind<=2;
            else if(store_kind==0 && xfer_depth) store_kind<=1;
            else begin row<=row+1; store_kind<=xfer_color ? 2'd0 : 2'd1; end
        end
    endtask
    // After a COPY clip step: check an axis, finish setup or fetch the next word.
    task automatic copy_clip_next;
        begin
            if(copy_setup_step==4 || copy_setup_step==11) state<=S_COPY_CLIP_CHECK;
            else if(copy_setup_step==13) state<=S_COPY_INIT_PREP;
            else begin
                copy_setup_step<=copy_setup_step+1;
                capture_index<=copy_parameter_offset(copy_setup_step+4'd1); state<=S_COPY_FETCH_REQ;
            end
        end
    endtask
    task automatic next_tile;
        begin
            // The pass completes once its last tile stores have reached SDRAM.
            if(tile_index==299) state<=S_PASS_DRAIN;
            else begin
                tile_index<=tile_index+1;
                if(tile_x_index==19) begin tile_x_index<=0; tile_y_index<=tile_y_index+1; end
                else tile_x_index<=tile_x_index+1;
                state<=S_ENTRY_CMD;
            end
        end
    endtask

    // COPY setup is off the fragment path. Each candidate reuses one signed
    // subtract/compare datapath and one raw word fetched from native packet RAM.
    always @* begin
        copy_clip_left=0; copy_clip_right=copy_raw_coordinate; copy_clip_bound=copy_low;
        case(copy_setup_step)
        3: begin copy_clip_left=$signed({22'd0,copy_image_width}); copy_clip_bound=copy_high; end
        4: begin copy_clip_left=33'sd640; copy_clip_bound=copy_high; end
        10: begin copy_clip_left=$signed({22'd0,copy_image_height}); copy_clip_bound=copy_high; end
        11: begin copy_clip_left=33'sd480; copy_clip_bound=copy_high; end
        default: begin end
        endcase
    end

    always @* begin
        status_snapshot=0; capabilities=0;
        status_snapshot[8 +:8]={4'b0,fault,sealed,busy,ready};
        status_snapshot[16 +:32]=epoch; status_snapshot[48 +:32]=completed_sequence;
        status_snapshot[80 +:32]=fence_token; status_snapshot[112 +:8]={7'd0,front_id};
        status_snapshot[120 +:8]={5'd0,depth_valid,color_valid};
        status_snapshot[128 +:64]=cycle_counter;
        status_snapshot[192 +:64]={32'd0,scanout_underflows};
        status_snapshot[256 +:32]={24'd0,fault_code};
        status_snapshot[288 +:32]=present_token;
        status_snapshot[448 +:8]=host_fault;
        capabilities[0 +:32]=32'h20080200;
        capabilities[32 +:32]=MEMORY_BYTES;
        capabilities[64 +:32]={9'd0,HEAP_BASE};
        capabilities[96 +:32]=1024; capabilities[128 +:32]=320;
        capabilities[160 +:32]=1048576; capabilities[192 +:32]=CORE_HZ;
        capabilities[224 +:32]=HOST_DIVIDER_METADATA; capabilities[256 +:32]=PIXEL_DIVIDER;
        capabilities[288 +:32]=256; capabilities[320 +:32]=2;
        capabilities[352 +:32]=1024; capabilities[384 +:32]=2048;
        capabilities[416 +:32]=640; capabilities[448 +:32]=480;
        // Feature bit 8: kind-4 vertex triangles (GPU triangle setup).
        capabilities[480 +:32]=32'h1ff;
    end

    wire [22:0] current_row_pixel = global_pixel(tile_origin_x,tile_origin_y+{4'd0,row});
    wire [22:0] store_address = store_kind==0 ? color_base(target_id)+(current_row_pixel<<1) :
        DEPTH_BASE+(current_row_pixel<<2)+(store_kind==2 ? 23'd64 : 23'd0);
    wire [9:0] store_pixel_address = {row,5'd0}+
        (store_kind==0 ? {4'd0,beat,1'b0} : (store_kind==2 ? 10'd16 : 10'd0)+{5'd0,beat});

    always @* begin
        mem_cmd_valid=0; mem_cmd_write=0; mem_cmd_addr=0; mem_cmd_words=0;
        mem_w_valid=0; mem_w_data=0; mem_w_strb=0; mem_r_ready=0;
        mem_cmd_valid[0]=scan_cmd_valid; mem_cmd_write[0]=scan_cmd_write;
        mem_cmd_addr[0 +:23]=scan_cmd_addr; mem_cmd_words[0 +:5]=scan_cmd_words;
        mem_r_ready[0]=scan_r_ready;
        mem_cmd_valid[4]=tex_cmd_valid; mem_cmd_write[4]=tex_cmd_write;
        mem_cmd_addr[4*23 +:23]=tex_cmd_addr; mem_cmd_words[4*5 +:5]=tex_cmd_words;
        mem_w_valid[4]=tex_w_valid; mem_w_data[4*32 +:32]=tex_w_data; mem_w_strb[4*4 +:4]=tex_w_strb;
        mem_r_ready[4]=tex_r_ready;
        payload_req=0; payload_offset=0; response_valid=0; response_data=0;
        // Native SDRAM output feeds one retained word before the distributed
        // record/header decoders. The stage accepts and publishes one word per
        // clock; the final word retires in S_RECORD_DONE before draw launch.
        tile_cmd_word_we=record_load_valid && (state==S_RECORD_DATA || state==S_RECORD_DONE) &&
            !abort_pending && !fault_pending && !foreground_quiet && !renderer_reset;
        tile_cmd_word_index=record_load_index; tile_cmd_word_data=record_load_data;
        // Kind-4 setup writes the renderer's flat-triangle words itself.
        if(setup_word_we) begin
            tile_cmd_word_we=state==S_SETUP && !abort_pending && !fault_pending && !foreground_quiet && !renderer_reset;
            tile_cmd_word_index=setup_word_index; tile_cmd_word_data=setup_word_data;
        end
        tile_cmd_valid=0; tile_pix_we=0; tile_pix_addr=pixel_index[9:0];
        tile_pix_color=clear_color; tile_pix_depth=clear_depth;
        tile_pix_re=0; tile_pix_raddr=store_pixel_address;
        reply_ram_we=0; reply_ram_re=0; reply_ram_waddr=read_cursor;
        reply_ram_raddr=reply_index-36; reply_ram_wdata={8'd0,read_word_hold[read_lane*8 +:8]};
        copy_ram_we=0; copy_ram_re=0; copy_ram_waddr=copy_comp[8:0];
        copy_ram_raddr=copy_word[8:0]; copy_ram_wdata=copy_composed;
        upload_ram_we=0; upload_ram_re=0;
        upload_ram_waddr={5'd0,beat[3:0],1'b0};
        upload_ram_raddr={5'd0,beat[3:0],1'b0};
        upload_ram_wdata=packed_word[15:0];
        case(state)
        S_BOOT_CMD: begin
            mem_cmd_valid[3]=1; mem_cmd_write[3]=1;
            mem_cmd_addr[3*23 +:23]=boot_address; mem_cmd_words[3*5 +:5]=16;
        end
        S_BOOT_DATA: begin
            mem_w_valid[3]=1; mem_w_data[3*32 +:32]=boot_address>=DEPTH_BASE ? 32'h00ffffff : 0;
            mem_w_strb[3*4 +:4]=15;
        end
        S_CAPTURE_REQ,S_COPY_FETCH_REQ: begin payload_req=1; payload_offset={4'd0,capture_index}; end
        S_UPLOAD_CMD: begin
            mem_cmd_valid[1]=1; mem_cmd_write[1]=1;
            mem_cmd_addr[23 +:23]=upload_current[22:0]&23'h7ffffc; mem_cmd_words[5 +:5]=upload_words;
        end
        S_UPLOAD_HEADER_REQ,S_UPLOAD_CODE_REQ: begin
            // Never address bytes beyond the published packet lease. A
            // truncated encoding faults instead of waiting for missing data.
            payload_req=upload_encoded_available;
            payload_offset=10'd8+read_cursor;
        end
        S_UPLOAD_STAGE_LOW: upload_ram_we=1;
        S_UPLOAD_STAGE_HIGH: begin
            upload_ram_we=1; upload_ram_waddr={5'd0,beat[3:0],1'b1};
            upload_ram_wdata=packed_word[31:16];
        end
        S_UPLOAD_STAGE_MASK: begin
            upload_ram_we=1; upload_ram_waddr={6'd2,beat[3:0]};
            upload_ram_wdata={12'd0,packed_mask};
        end
        S_UPLOAD_RAM_LOW: upload_ram_re=1;
        S_UPLOAD_RAM_HIGH: begin upload_ram_re=1; upload_ram_raddr={5'd0,beat[3:0],1'b1}; end
        S_UPLOAD_RAM_MASK: begin upload_ram_re=1; upload_ram_raddr={6'd2,beat[3:0]}; end
        S_UPLOAD_WORD: begin
            mem_w_valid[1]=1;
            mem_w_data[32 +:32]=packed_word;
            mem_w_strb[4 +:4]=upload_ram_rdata[3:0];
            // A successful handoff frees the read port to prefetch the next
            // low half. Until then the native mask and packed word remain stable.
            if(mem_w_ready[1] && beat+1!=upload_words) begin
                upload_ram_re=1;
                upload_ram_raddr={5'd0,(beat[3:0]+4'd1),1'b0};
            end
        end
        S_DESC_CMD: begin
            mem_cmd_valid[2]=1; mem_cmd_addr[46 +:23]=upload_address; mem_cmd_words[10 +:5]=8;
        end
        S_ENTRY_CMD: begin
            mem_cmd_valid[2]=1; mem_cmd_addr[46 +:23]=table_address+{11'd0,tile_index,3'b0}; mem_cmd_words[10 +:5]=2;
        end
        S_REF_CMD: begin
            mem_cmd_valid[2]=1; mem_cmd_addr[46 +:23]=list_address+{reference_index,2'b0}; mem_cmd_words[10 +:5]=1;
        end
        S_RECORD_CMD: begin
            mem_cmd_valid[2]=1; mem_cmd_addr[46 +:23]=record_address+{14'd0,record_word,2'b0}; mem_cmd_words[10 +:5]=16;
        end
        S_DESC_DATA,S_ENTRY_DATA,S_REF_DATA: mem_r_ready[2]=1;
        S_RECORD_DATA: mem_r_ready[2]=1;
        S_TILE_INIT: tile_pix_we={clear_depth_enable,clear_color_enable};
        S_LOAD_CMD: begin
            // Only after earlier tile stores complete: S_LOAD_DONE then
            // waits for this load's own completion.
            mem_cmd_valid[3]=mem3_outstanding==0; mem_cmd_addr[69 +:23]=store_address;
            mem_cmd_words[15 +:5]=16;
        end
        S_LOAD_DATA: begin
            // A color word fills two tile pixels: its low half is written
            // first while the response is held, then the word is consumed.
            mem_r_ready[3]=store_kind!=0 || load_half;
            tile_pix_color=load_half ? mem_r_data[96+16 +:16] : mem_r_data[96 +:16];
            tile_pix_depth=mem_r_data[96 +:24];
            tile_pix_addr=store_pixel_address+{9'd0,load_half};
            if(mem_r_valid[3]) tile_pix_we=store_kind==0 ? 2'b01 : 2'b10;
        end
        S_DRAW_START: tile_cmd_valid=1;
        S_STORE_CMD: begin
            mem_cmd_valid[3]=1; mem_cmd_write[3]=1; mem_cmd_addr[69 +:23]=store_address;
            mem_cmd_words[15 +:5]=16;
        end
        // The tile RAM output register holds a pixel until the next read, so
        // a stalled SDRAM fill simply withholds the following read enable.
        S_STORE_PREFETCH: tile_pix_re=1;
        S_STORE_HIGH: begin tile_pix_re=1; tile_pix_raddr=store_pixel_address+10'd1; end
        S_STORE_WORD: begin
            mem_w_valid[3]=1; mem_w_strb[12 +:4]=15;
            if(store_constant) mem_w_data[96 +:32]=store_kind==0 ? {clear_color,clear_color} : {8'd0,clear_depth};
            else mem_w_data[96 +:32]=store_kind==0 ? {tile_pix_rcolor,held_color} : {8'd0,tile_pix_rdepth};
            if(!store_constant && mem_w_ready[3] && beat!=15) begin
                tile_pix_re=1;
                tile_pix_raddr=store_pixel_address+(store_kind==0 ? 10'd2 : 10'd1);
            end
        end
        S_REPLY: begin
            response_valid=1;
            response_data=(reply_has_readback && reply_index>=36) ? reply_data_hold : reply_byte(reply_index);
        end
        S_REPLY_RAM_REQ: reply_ram_re=1;
        S_READ_CMD: begin
            mem_cmd_valid[2]=1; mem_cmd_addr[46 +:23]=read_next_address;
            mem_cmd_words[10 +:5]=read_burst_words;
        end
        S_READ_DATA: mem_r_ready[2]=1;
        S_READ_BYTES: reply_ram_we=read_cursor<read_length;
        S_COPY_READ_CMD: begin
            mem_cmd_valid[5]=1;
            mem_cmd_addr[115 +:23]={copy_source_row[22:2],2'b00}+{11'd0,copy_word,2'b00};
            mem_cmd_words[25 +:5]=copy_read_burst;
        end
        S_COPY_READ_DATA: begin
            mem_r_ready[5]=1; copy_ram_we=mem_r_valid[5] && !copy_skip_compose;
        end
        // Odd phase-shifted rows end with one high half from the last word.
        S_COPY_FLUSH: begin copy_ram_we=1; copy_ram_wdata={16'd0,copy_prev[31:16]}; end
        S_COPY_WRITE_CMD: begin
            mem_cmd_valid[5]=1; mem_cmd_write[5]=1;
            mem_cmd_addr[115 +:23]={copy_destination_row[22:2],2'b00}+{11'd0,copy_word,2'b00};
            mem_cmd_words[25 +:5]=copy_write_burst;
        end
        S_COPY_PREFETCH: copy_ram_re=1;
        S_COPY_WRITE_DATA: begin
            // The RAM output holds word copy_word; prefetch the next one as
            // this one is accepted, so the burst fills at one word per edge.
            mem_w_valid[5]=1; mem_w_data[160 +:32]=copy_ram_rdata;
            mem_w_strb[20 +:4]={copy_high_valid,copy_high_valid,copy_low_valid,copy_low_valid};
            if(mem_w_ready[5]) begin copy_ram_re=1; copy_ram_raddr=copy_word[8:0]+9'd1; end
        end
        default: begin end
        endcase
        // Clear-back of the pixel read for STORE on the previous edge. No
        // other tile write occurs during a store.
        if(clear_back_valid) begin
            tile_pix_we=clear_back_we; tile_pix_addr=clear_back_addr;
            tile_pix_color=clear_color; tile_pix_depth=clear_depth;
        end
        // Stop issuing foreground work during recovery, but continue the
        // accepted payload/response handshakes so native transactions drain.
        if(abort_pending || fault_pending) begin
            mem_cmd_valid[1]=0; mem_cmd_valid[2]=0; mem_cmd_valid[3]=0; mem_cmd_valid[5]=0;
            tile_cmd_valid=0;
        end
        if(foreground_quiet) begin
            mem_cmd_valid[5:1]=0;
            tile_cmd_valid=0;
        end
    end

    // This word stage is always drained by the idle renderer while fetching a
    // primitive. Recovery cancels its valid bit and suppresses its write port,
    // so a word accepted on the abort/fault edge cannot leak into a later draw.
    wire record_load_accept = state==S_RECORD_DATA && mem_r_valid[2] && mem_r_ready[2] &&
        !reset && !renderer_reset && !abort_pending && !fault_pending && !foreground_quiet;
    always @(posedge clk) begin
        if(reset || renderer_reset) record_load_valid<=0;
        else record_load_valid<=record_load_accept;
        if(record_load_accept) begin
            record_load_index<=record_word+{2'd0,beat};
            record_load_data<=mem_r_data[2*32 +:32];
        end
    end

    always @(posedge clk) begin
        if(reset) begin
            state<=S_BOOT_WAIT; initialized<=0; front_id<=0; sealed<=0; color_valid<=0; depth_valid<=0;
            pass_active<=0; copy_active<=0; epoch<=1; completed_sequence<=0; fence_token<=0; present_token<=0;
            cycle_counter<=0; pixel_phase<=0; video_pixel_ce<=0;
            abort_sync1<=0; abort_sync2<=0; abort_previous<=0; abort_pending<=0; fault_pending<=0; fault_code<=0;
            foreground_quiet<=0;
            renderer_reset<=0; host_abort<=0; host_cmd_pop<=0; tex_flush<=0; pending_memory<=0;
            mem3_outstanding<=0;
            capture_index<=0; capture_length<=0;
            packet_word<=0; capture_invalid<=0; copy_command_invalid<=0;
            target_id<=1; clear_color_enable<=1; clear_depth_enable<=1; depth_discard<=0;
            skip_empty<=0; depth_keep<=0;
            clear_color<=0; clear_depth<=24'hffffff;
            xfer_color<=0; xfer_depth<=0; store_constant<=0; load_half<=0;
            tile_ram_clear<=0; clear_back_valid<=0; clear_back_we<=0; clear_back_addr<=0;
            descriptor_invalid<=0; setup_started<=0; record_long_bad<=0; last_reference<=0;
            table_address<=0; list_address<=0; record_address<=0; reference_count<=0; reference_index<=0; references_seen<=0;
            tile_x_index<=0; tile_y_index<=0; tile_index<=0; pixel_index<=0; record_word<=0; beat<=0; row<=0; store_kind<=0;
            held_color<=0; packed_word<=0; packed_mask<=0; boot_address<=0;
            upload_address<=0; upload_length<=0; upload_cursor<=0; upload_chunk<=0; upload_fill<=0; upload_prefix<=0; upload_words<=0;
            upload_descriptor<=0;
            read_address<=0; read_length<=0; read_cursor<=0; read_next_address<=0;
            read_words_remaining<=0; read_burst_words<=0; read_word_hold<=0; read_lane<=0; read_first<=0; read_done_hold<=0;
            reply_index<=0; reply_length<=0; reply_token<=0; reply_caps<=0;
            present_wait<=0; present_reply_due<=0; present_reply<=0; present_sequence<=0;
            reply_cycle_snapshot<=0; reply_underflow_snapshot<=0;
            reply_flags_snapshot<=0; reply_host_fault_snapshot<=0;
            reply_has_snapshot<=0; reply_has_readback<=0; reply_data_hold<=0;
            copy_source_kind<=0; copy_source_id<=0; copy_target_id<=0;
            copy_base<=0; copy_pitch<=0; copy_image_width<=0; copy_image_height<=0;
            copy_reverse<=0; copy_previous_valid<=0; copy_source_row<=0; copy_destination_row<=0;
            copy_destination_start_y_r<=0;
            copy_low<=0; copy_high<=0; copy_setup_step<=0; copy_clip_held<=0;
            copy_first_source_x<=0; copy_first_source_y<=0;
            copy_first_destination_x<=0; copy_first_destination_y<=0;
            copy_count_x<=0; copy_count_y<=0; copy_row_number<=0;
            copy_word<=0; copy_burst_end<=0; copy_comp<=0; copy_prev<=0;
            copy_address_steps<=0; copy_extent_steps<=0; copy_extent_address<=0;
        end else begin
            cycle_counter<=cycle_counter+1;
            pixel_phase<=pixel_phase+1; video_pixel_ce<=pixel_tick;
            renderer_reset<=0; host_abort<=0; host_cmd_pop<=0; tex_flush<=0;
            clear_back_valid<=tile_pix_re && !store_constant && (clear_back_color || clear_back_depth);
            clear_back_addr<=tile_pix_raddr; clear_back_we<={clear_back_depth,clear_back_color};
            abort_sync1<=abort_request; abort_sync2<=abort_sync1; abort_previous<=abort_sync2;
            if(abort_sync2 && !abort_previous) begin
                abort_pending<=1;
                if(pass_active) begin color_valid[target_id]<=0; depth_valid<=0; end
                if(copy_active) color_valid[copy_target_id]<=0;
                sealed<=0; present_wait<=0; present_reply_due<=0;
            end
            for(i=0;i<6;i=i+1) begin
                if(mem_done[i]) pending_memory[i]<=0;
                if(mem_cmd_valid[i] && mem_cmd_ready[i]) pending_memory[i]<=1;
            end
            mem3_outstanding<=mem3_next;
            pending_memory[3]<=mem3_next!=0;
            if(mem_done[2]) read_done_hold<=1;
            // Abort lets the active primitive finish before stopping texture
            // fetches. A fault may cancel that work once accepted memory has
            // drained. Keep quiet asserted through the renderer reset and the
            // host-link flush, so an unaccepted cache miss cannot sneak out.
            if(fault_pending || (abort_pending && !tile_busy)) foreground_quiet<=1;
            if(!abort_pending && state!=S_RECOVER && !host_abort && ((|mem_error) || host_fault!=0 || tile_fault || tex_fault))
                raise_fault(host_fault!=0 ? 8'd1 : ((|mem_error) ? 8'd8 : 8'd6));
            if(abort_pending && !tile_busy && foreground_quiet && pending_memory[5:1]==0) begin
                state<=S_RECOVER; renderer_reset<=1; host_abort<=1;
                abort_pending<=0; fault_pending<=0; fault_code<=0;
                completed_sequence<=0; fence_token<=0; present_token<=0;
                pass_active<=0; copy_active<=0; sealed<=0;
                present_wait<=0; present_reply_due<=0; present_reply<=0;
                if(epoch==32'hffffffff) begin fault_pending<=1; fault_code<=8'hff; state<=S_FAULT; host_abort<=0; end
                else epoch<=epoch+1;
            end else if(fault_pending && foreground_quiet && pending_memory[5:1]==0) begin
                state<=S_FAULT; renderer_reset<=1;
            end else begin
                // The pending PRESENT swaps at vertical blank whatever the
                // executor is doing: only WRITE_HEAP can run meanwhile, and it
                // touches neither target_id nor reply_token.
                if(present_wait && vblank_pulse && !fault_pending && !abort_pending) begin
                    front_id<=target_id; present_token<=reply_token; sealed<=0;
                    present_wait<=0; present_reply_due<=1;
                end
                case(state)
                S_BOOT_WAIT: if(memory_initialized) begin boot_address<=0; state<=S_BOOT_CMD; end
                S_BOOT_CMD: if(mem_cmd_ready[3]) begin beat<=0; state<=S_BOOT_DATA; end
                S_BOOT_DATA: if(mem_w_ready[3]) begin if(beat==15) state<=S_BOOT_DONE; else beat<=beat+1; end
                S_BOOT_DONE: if(mem_done[3]) begin
                    if(boot_address+64==HEAP_BASE) begin initialized<=1; color_valid<=3; depth_valid<=1; state<=S_IDLE; end
                    else begin boot_address<=boot_address+64; state<=S_BOOT_CMD; end
                end
                S_IDLE: if(present_reply_due) begin
                    // The swapped PRESENT's reply precedes every later reply.
                    present_reply_due<=0; present_reply<=1; start_reply(reply_token,0,0);
                end else if(initialized && !host_recovering && host_cmd_valid && !host_cmd_pop &&
                        (!present_wait || host_cmd_opcode==3)) begin
                    capture_index<=0; capture_invalid<=0; copy_command_invalid<=0;
                    case(host_cmd_opcode)
                    1,2: begin capture_length<=0; if(host_cmd_length!=0) raise_fault(2); else state<=S_EXECUTE; end
                    3: begin capture_length<=8; if(host_cmd_length<=8 || host_cmd_length>1024) raise_fault(2); else state<=S_CAPTURE_REQ; end
                    4,6: begin capture_length<=4; if(host_cmd_length!=4) raise_fault(2); else state<=S_CAPTURE_REQ; end
                    5: begin capture_length<=56; if(host_cmd_length!=56) raise_fault(2); else state<=S_CAPTURE_REQ; end
                    7: begin capture_length<=8; if(host_cmd_length!=8) raise_fault(2); else state<=S_CAPTURE_REQ; end
                    8: begin capture_length<=12; if(host_cmd_length!=12) raise_fault(2); else state<=S_CAPTURE_REQ; end
                    default: raise_fault(2);
                    endcase
                end
                S_CAPTURE_REQ: state<=S_CAPTURE_WAIT;
                S_CAPTURE_WAIT: if(payload_valid) begin
                    packet_word<=capture_word_data;
                    if(capture_index[1:0]==3) case(opcode)
                    3: case(capture_index[5:2])
                        0: begin
                            upload_address<=capture_word_data[22:0];
                            if(!valid_heap(capture_word_data,33'd1,0)) capture_invalid<=1;
                        end
                        1: begin
                            upload_length<=capture_word_data[10:0];
                            if(capture_word_data==0 || capture_word_data>956 ||
                               {1'b0,upload_address}+{13'd0,capture_word_data[10:0]}>24'h800000) capture_invalid<=1;
                        end
                        default: capture_invalid<=1;
                    endcase
                    4: begin
                        upload_address<=capture_word_data[22:0];
                        if(!valid_heap(capture_word_data,33'd32,1)) capture_invalid<=1;
                    end
                    7: if(capture_index[5:2]==0) begin
                        target_id<=capture_word_data[0];
                        if(|capture_word_data[31:1]) capture_invalid<=1;
                    end
                    8: case(capture_index[5:2])
                        0: begin
                            read_address<=capture_word_data[22:0];
                            if(|capture_word_data[31:23]) capture_invalid<=1;
                        end
                        1: begin
                            read_length<=capture_word_data[9:0];
                            if(capture_word_data==0 || capture_word_data>512 ||
                               {1'b0,read_address}+{14'd0,capture_word_data[9:0]}>24'h800000) capture_invalid<=1;
                        end
                        default: begin end // token is the final packet_word
                    endcase
                    5: case(capture_index[5:2])
                        0: begin
                            copy_source_kind<=capture_word_data[0];
                            if(|capture_word_data[31:1]) copy_command_invalid<=1;
                        end
                        1: begin
                            copy_source_id<=capture_word_data[0];
                            if((|capture_word_data[31:1]) || (copy_source_kind && capture_word_data!=0)) copy_command_invalid<=1;
                        end
                        2: begin
                            copy_target_id<=capture_word_data[0];
                            if(|capture_word_data[31:1]) copy_command_invalid<=1;
                        end
                        7,8: if(capture_word_data[31]) copy_command_invalid<=1;
                        9: begin
                            copy_base<=copy_source_kind ? capture_word_data[22:0] : color_base(copy_source_id);
                            if(copy_source_kind) begin
                                if(!valid_heap(capture_word_data,33'd1,1)) capture_invalid<=1;
                            end else if(capture_word_data!=0) copy_command_invalid<=1;
                        end
                        10: begin
                            copy_image_width<=copy_source_kind ? capture_word_data[10:0] : 11'd640;
                            if(copy_source_kind) begin
                                if(capture_word_data==0 || capture_word_data>1024) capture_invalid<=1;
                            end else if(capture_word_data!=0) copy_command_invalid<=1;
                        end
                        11: begin
                            copy_image_height<=copy_source_kind ? capture_word_data[10:0] : 11'd480;
                            if(copy_source_kind) begin
                                if(capture_word_data==0 || capture_word_data>1024) capture_invalid<=1;
                            end else if(capture_word_data!=0) copy_command_invalid<=1;
                        end
                        12: begin
                            copy_pitch<=copy_source_kind ? capture_word_data[22:0] : 23'd1280;
                            if(copy_source_kind) begin
                                if(capture_word_data[1:0]!=0 || (|capture_word_data[31:23]) ||
                                   capture_word_data[22:0] < {11'd0,copy_image_width,1'b0}) capture_invalid<=1;
                            end else if(capture_word_data!=0) copy_command_invalid<=1;
                        end
                        13: if(capture_word_data!=0) copy_command_invalid<=1;
                        default: begin end // coordinate words are re-fetched for setup
                    endcase
                    default: begin end
                    endcase
                    if(capture_index+1==capture_length) state<=S_EXECUTE;
                    else begin capture_index<=capture_index+1; state<=S_CAPTURE_REQ; end
                end
                S_EXECUTE: case(opcode)
                    1: begin reply_caps<=1; start_reply(0,1,0); end
                    2: begin
                        reply_caps<=0; reply_cycle_snapshot<=cycle_counter;
                        reply_underflow_snapshot<=scanout_underflows;
                        reply_flags_snapshot<=status_snapshot[8 +:8];
                        reply_host_fault_snapshot<=host_fault;
                        start_reply(0,1,0);
                    end
                    3: if(capture_invalid) raise_fault(3);
                       else begin
                           upload_cursor<=0; read_cursor<=0; read_lane<=0;
                           read_length<=payload_length-11'd8;
                           upload_descriptor<=0; state<=S_UPLOAD_PREP;
                       end
                    4: if(capture_invalid) raise_fault(3);
                       else begin tex_flush<=1; state<=S_DESC_CMD; end
                    6: begin fence_token<=packet_word; start_reply(packet_word,0,0); end
                    7: if(capture_invalid || target_id==front_id || sealed || !color_valid[target_id]) raise_fault(4);
                       else begin
                           sealed<=1; present_wait<=1; present_sequence<=command_sequence;
                           reply_token<=packet_word; complete_command();
                       end
                    8: if(capture_invalid) raise_fault(3);
                       else begin
                           read_cursor<=0; read_next_address<=read_address&23'h7ffffc;
                           read_words_remaining<=read_initial_words;
                           read_burst_words<=read_initial_words>8'd16 ? 5'd16 : read_initial_words[4:0];
                           read_first<=1; state<=S_READ_CMD;
                       end
                    5: if(copy_command_invalid || copy_target_id==front_id || sealed) raise_fault(4);
                       else begin
                           copy_previous_valid<=color_valid[copy_target_id];
                           copy_extent_steps<=0; copy_extent_address<=copy_source_kind ? {1'b0,copy_base} : 0;
                           state<=S_COPY_VALIDATE;
                       end
                    default: raise_fault(2);
                endcase
                S_UPLOAD_PREP: begin
                    upload_prefix<=upload_current[1:0];
                    upload_chunk<=upload_next_chunk;
                    upload_words<=upload_rounded_bytes[6:2];
                    upload_fill<=0; beat<=0; packed_word<=0; packed_mask<=0;
                    state<=S_UPLOAD_NEXT;
                end
                S_UPLOAD_CMD: if(mem_cmd_ready[1]) state<=S_UPLOAD_RAM_LOW;
                S_UPLOAD_NEXT: begin
                    if(read_lane!=0) state<=S_UPLOAD_EMIT;
                    else if(upload_group_offset==0) state<=S_UPLOAD_HEADER_REQ;
                    else state<=S_UPLOAD_CODE;
                end
                S_UPLOAD_HEADER_REQ: begin
                    if(!upload_encoded_available) raise_fault(3);
                    else state<=S_UPLOAD_HEADER_WAIT;
                end
                S_UPLOAD_HEADER_WAIT: if(payload_valid) begin
                    upload_descriptor<=payload_data; read_cursor<=read_cursor+1;
                    state<=S_UPLOAD_CODE;
                end
                S_UPLOAD_CODE: begin
                    capture_index<=0;
                    if(upload_code==0) state<=S_UPLOAD_EMIT;
                    else state<=S_UPLOAD_CODE_REQ;
                end
                S_UPLOAD_CODE_REQ: begin
                    if(!upload_encoded_available) raise_fault(3);
                    else state<=S_UPLOAD_CODE_WAIT;
                end
                S_UPLOAD_CODE_WAIT: if(payload_valid) begin
                    packet_word<=capture_word_data; read_cursor<=read_cursor+1;
                    if(capture_index[1:0]==upload_literal_last) begin
                        state<=S_UPLOAD_EMIT;
                    end else begin capture_index<=capture_index+1; state<=S_UPLOAD_CODE_REQ; end
                end
                S_UPLOAD_EMIT: begin
                    packed_word[upload_lane*8 +:8]<=upload_decoded_byte;
                    if(upload_code==3) packet_word<={8'd0,packet_word[31:8]};
                    packed_mask[upload_lane]<=1;
                    read_lane<=read_lane+1;
                    upload_fill<=upload_fill+1;
                    if(read_lane==3) upload_descriptor<={2'b0,upload_descriptor[7:2]};
                    // Malformed streams may have written earlier complete
                    // chunks. The current chunk is not submitted on failure.
                    // Only decoded_length bytes escape a partial final word;
                    // its unused high bytes are ignored, never memory writes.
                    if(upload_final_byte &&
                       (read_cursor!=read_length || upload_descriptor[7:2]!=0)) raise_fault(3);
                    if(upload_lane==3 || upload_fill+1==upload_chunk) state<=S_UPLOAD_STAGE_LOW;
                    else state<=read_lane==3 ? S_UPLOAD_NEXT : S_UPLOAD_EMIT;
                end
                S_UPLOAD_STAGE_LOW: state<=S_UPLOAD_STAGE_HIGH;
                S_UPLOAD_STAGE_HIGH: state<=S_UPLOAD_STAGE_MASK;
                S_UPLOAD_STAGE_MASK: begin
                    packed_word<=0; packed_mask<=0; beat<=beat+1;
                    if(upload_fill==upload_chunk) begin beat<=0; state<=S_UPLOAD_CMD; end
                    else state<=S_UPLOAD_NEXT;
                end
                S_UPLOAD_RAM_LOW: state<=S_UPLOAD_RAM_HIGH;
                S_UPLOAD_RAM_HIGH: begin packed_word[15:0]<=upload_ram_rdata; state<=S_UPLOAD_RAM_MASK; end
                S_UPLOAD_RAM_MASK: begin packed_word[31:16]<=upload_ram_rdata; state<=S_UPLOAD_WORD; end
                S_UPLOAD_WORD: if(mem_w_ready[1]) begin
                    if(beat+1==upload_words) state<=S_UPLOAD_DONE;
                    else begin beat<=beat+1; state<=S_UPLOAD_RAM_HIGH; end
                end
                S_UPLOAD_DONE: if(mem_done[1]) begin
                    upload_cursor<=upload_cursor+upload_chunk;
                    if(upload_cursor+upload_chunk==upload_length) complete_command(); else state<=S_UPLOAD_PREP;
                end
                S_DESC_CMD: if(mem_cmd_ready[2]) begin beat<=0; descriptor_invalid<=0; state<=S_DESC_DATA; end
                S_DESC_DATA: if(mem_r_valid[2]) begin
                    // Validate each full u32 on arrival, retaining only decoded
                    // pass fields. No attachment is mutated before DONE checks
                    // all words and ownership/LOAD validity below.
                    case(beat)
                    0: if(mem_r_data[64 +:32]!=32'h3153504e) descriptor_invalid<=1;
                    1: begin target_id<=mem_r_data[64]; if(mem_r_data[64 +:32]>1) descriptor_invalid<=1; end
                    2: begin
                        clear_color_enable<=mem_r_data[64]; clear_depth_enable<=mem_r_data[65];
                        depth_discard<=mem_r_data[66]; skip_empty<=mem_r_data[67];
                        if(mem_r_data[64 +:32]>15) descriptor_invalid<=1;
                    end
                    3: begin clear_color<=mem_r_data[64 +:16]; if(|mem_r_data[80 +:16]) descriptor_invalid<=1; end
                    4: begin clear_depth<=mem_r_data[64 +:24]; if(|mem_r_data[88 +:8]) descriptor_invalid<=1; end
                    5: begin
                        table_address<=mem_r_data[64 +:23];
                        if(!valid_heap(mem_r_data[64 +:32],33'd2400,1)) descriptor_invalid<=1;
                    end
                    6: if(mem_r_data[64 +:32]!=300) descriptor_invalid<=1;
                    7: if(mem_r_data[64 +:32]!=0) descriptor_invalid<=1;
                    default: descriptor_invalid<=1;
                    endcase
                    beat<=beat+1; if(mem_r_last[2]) state<=S_DESC_DONE;
                end
                S_DESC_DONE: if(mem_done[2]) begin
                    if(descriptor_invalid || target_id==front_id || sealed) raise_fault(6);
                    // SKIP keeps untouched tiles, so the target color must
                    // already be valid, exactly as for a color LOAD.
                    else if(((!clear_color_enable || skip_empty) && !color_valid[target_id]) ||
                            (!clear_depth_enable && !depth_valid)) raise_fault(5);
                    else begin
                        depth_keep<=depth_valid;
                        color_valid[target_id]<=0; depth_valid<=0; pass_active<=1; tile_ram_clear<=0;
                        tile_index<=0; tile_x_index<=0; tile_y_index<=0; references_seen<=0; state<=S_ENTRY_CMD;
                    end
                end
                S_ENTRY_CMD: if(mem_cmd_ready[2]) begin beat<=0; state<=S_ENTRY_DATA; end
                S_ENTRY_DATA: if(mem_r_valid[2]) begin
                    if(beat==0) list_address<=mem_r_data[64 +:23]; else reference_count<=mem_r_data[64 +:21];
                    if((beat==0 && |mem_r_data[64+23 +:9]) || (beat==1 && |mem_r_data[64+21 +:11])) raise_fault(6);
                    beat<=beat+1; if(mem_r_last[2]) state<=S_ENTRY_DONE;
                end
                S_ENTRY_DONE: if(mem_done[2]) begin
                    if((reference_count==0 && list_address!=0) || reference_count>21'd1048576 || pass_reference_total>22'd1048576 ||
                       (reference_count!=0 && !valid_heap({9'd0,list_address},{10'd0,reference_count,2'b0},1))) raise_fault(7);
                    else begin
                        references_seen<=pass_reference_total[20:0]; reference_index<=0; pixel_index<=0;
                        row<=0; beat<=0; load_half<=0;
                        if(reference_count==0 && skip_empty) next_tile();
                        else if(reference_count==0) begin
                            // No draws: a loaded attachment is already correct
                            // in SDRAM. Only stored clears are written, as
                            // constants, without touching tile RAM.
                            store_constant<=1; xfer_color<=clear_color_enable;
                            xfer_depth<=clear_depth_enable && !depth_discard;
                            store_kind<=clear_color_enable ? 2'd0 : 2'd1;
                            if(clear_color_enable || (clear_depth_enable && !depth_discard)) state<=S_STORE_CMD;
                            else next_tile();
                        end else begin
                            // Loaded attachments burst-load; cleared ones need
                            // TILE_INIT only until a store has cleared them.
                            store_constant<=0;
                            xfer_color<=!clear_color_enable; xfer_depth<=!clear_depth_enable;
                            store_kind<=clear_color_enable ? 2'd1 : 2'd0;
                            if((clear_color_enable || clear_depth_enable) && !tile_ram_clear) state<=S_TILE_INIT;
                            else if(clear_color_enable && clear_depth_enable) state<=S_REF_CMD;
                            else state<=S_LOAD_CMD;
                        end
                    end
                end
                S_TILE_INIT: begin
                    if(pixel_index==1023) begin
                        if(clear_color_enable && clear_depth_enable) state<=S_REF_CMD; else state<=S_LOAD_CMD;
                    end else pixel_index<=pixel_index+1;
                end
                S_LOAD_CMD: if(mem_cmd_ready[3]) begin beat<=0; load_half<=0; state<=S_LOAD_DATA; end
                S_LOAD_DATA: if(mem_r_valid[3]) begin
                    if(store_kind==0 && !load_half) load_half<=1;
                    else begin
                        load_half<=0; beat<=beat+1;
                        if(mem_r_last[3]) state<=S_LOAD_DONE;
                    end
                end
                S_LOAD_DONE: if(mem_done[3]) begin
                    if(xfer_last) state<=S_REF_CMD;
                    else begin next_transfer(); state<=S_LOAD_CMD; end
                end
                S_REF_CMD: if(mem_cmd_ready[2]) state<=S_REF_DATA;
                S_REF_DATA: if(mem_r_valid[2]) begin
                    record_address<=mem_r_data[64 +:23];
                    // Every record has at least the 64-byte first burst; the
                    // 320-byte kinds are range-checked once word 0 is known.
                    if(!valid_heap(mem_r_data[64 +:32],33'd64,1)) raise_fault(3);
                    // Registered for S_RECORD_DONE and finish_reference, so
                    // neither range nor count comparison feeds those decisions.
                    record_long_bad<=!valid_heap(mem_r_data[64 +:32],33'd320,1);
                    last_reference<=reference_index+1==reference_count;
                    state<=S_REF_DONE;
                end
                S_REF_DONE: if(mem_done[2]) begin record_word<=0; state<=S_RECORD_CMD; end
                S_RECORD_CMD: if(mem_cmd_ready[2]) begin beat<=0; state<=S_RECORD_DATA; end
                S_RECORD_DATA: if(mem_r_valid[2]) begin beat<=beat+1; if(mem_r_last[2]) state<=S_RECORD_DONE; end
                S_RECORD_DONE: if(mem_done[2]) begin
                    if(record_word==0 && setup_vertex) begin setup_started<=0; state<=S_SETUP; end
                    else if(record_word==64) state<=S_DRAW_START;
                    else begin
                        if(record_word==0 && record_long_bad) raise_fault(3);
                        record_word<=record_word+16; state<=S_RECORD_CMD;
                    end
                end
                // The last first-burst word retires on the S_RECORD_DONE edge,
                // so setup starts one clock later, from the complete record.
                S_SETUP: begin
                    setup_started<=1;
                    if(setup_done) begin
                        if(setup_bad) raise_fault(6);
                        else if(setup_draw) state<=S_DRAW_START;
                        else finish_reference();
                    end
                end
                S_DRAW_START: if(tile_cmd_ready) state<=S_DRAW_WAIT;
                S_DRAW_WAIT: if(tile_done || !tile_busy) finish_reference();
                S_STORE_CMD: if(mem_cmd_ready[3]) begin
                    beat<=0; state<=store_constant ? S_STORE_WORD : S_STORE_PREFETCH;
                end
                S_STORE_PREFETCH: state<=store_kind==0 ? S_STORE_HIGH : S_STORE_WORD;
                S_STORE_HIGH: begin held_color<=tile_pix_rcolor; state<=S_STORE_WORD; end
                // Depth and constant words stream once per edge; RGB565 words
                // alternate with S_STORE_HIGH to read their second pixel. The
                // next burst is requested as soon as this one is staged: its
                // completion arrives later (mem3_outstanding).
                S_STORE_WORD: if(mem_w_ready[3]) begin
                    if(beat==15) begin
                        if(xfer_last) state<=S_STORE_DONE;
                        else begin next_transfer(); state<=S_STORE_CMD; end
                    end else begin
                        beat<=beat+1;
                        if(!store_constant && store_kind==0) state<=S_STORE_HIGH;
                    end
                end
                // Every burst of this tile is staged, so its tile RAM may be
                // reused; the stores themselves may still be finishing.
                S_STORE_DONE: begin
                    if(!store_constant) tile_ram_clear<=1;
                    next_tile();
                end
                S_PASS_DRAIN: if(mem3_outstanding==0) begin
                    color_valid[target_id]<=1; depth_valid<=!depth_discard && (!skip_empty || depth_keep); pass_active<=0;
                    complete_command();
                end
                S_REPLY: if(response_ready) begin
                    // A deferred PRESENT reply has no current command to retire.
                    if(reply_index+1==reply_length) begin
                        if(present_reply) begin present_reply<=0; state<=S_IDLE; end
                        else complete_command();
                    end
                    else begin
                        reply_index<=reply_index+1;
                        if(reply_has_readback && reply_index+1>=36) state<=S_REPLY_RAM_REQ;
                    end
                end
                S_REPLY_RAM_REQ: state<=S_REPLY_RAM_WAIT;
                S_REPLY_RAM_WAIT: begin reply_data_hold<=reply_ram_rdata[7:0]; state<=S_REPLY; end
                S_READ_CMD: if(mem_cmd_ready[2]) begin beat<=0; read_done_hold<=0; state<=S_READ_DATA; end
                S_READ_DATA: if(mem_r_valid[2]) begin
                    read_word_hold<=mem_r_data[64 +:32]; read_lane<=read_first ? read_address[1:0] : 0;
                    read_first<=0; beat<=beat+1; state<=S_READ_BYTES;
                end
                S_READ_BYTES: begin
                    if(read_cursor<read_length) read_cursor<=read_cursor+1;
                    if(read_lane==3 || read_cursor+1==read_length) begin
                        if(beat==read_burst_words) state<=S_READ_DONE; else state<=S_READ_DATA;
                    end else read_lane<=read_lane+1;
                end
                S_READ_DONE: if(mem_done[2] || read_done_hold) begin
                    if(read_words_remaining==read_burst_words) start_reply(packet_word,0,1);
                    else begin
                        read_words_remaining<=read_words_after_burst;
                        read_next_address<=read_next_address+{16'd0,read_burst_words,2'b0};
                        read_burst_words<=read_words_after_burst>8'd16 ? 5'd16 : read_words_after_burst[4:0];
                        state<=S_READ_CMD;
                    end
                end
                S_COPY_VALIDATE: begin
                    if(copy_source_kind && capture_invalid) raise_fault(3);
                    else if(!copy_source_kind && !color_valid[copy_source_id]) raise_fault(4);
                    else if(copy_source_kind && copy_extent_steps<copy_image_height) begin
                        copy_extent_address<=copy_extent_address+{1'b0,copy_pitch}; copy_extent_steps<=copy_extent_steps+1;
                        if(copy_extent_address+{1'b0,copy_pitch}>24'h800000) raise_fault(3);
                    end else begin
                        copy_low<=0; copy_setup_step<=0;
                        copy_address_steps<=0; copy_source_row<=copy_base; copy_row_number<=0;
                        capture_index<=copy_parameter_offset(0); state<=S_COPY_FETCH_REQ;
                    end
                end
                S_COPY_FETCH_REQ: state<=S_COPY_FETCH_WAIT;
                S_COPY_FETCH_WAIT: if(payload_valid) begin
                    packet_word<=capture_word_data;
                    if(capture_index[1:0]==3) state<=S_COPY_CLIP;
                    else begin capture_index<=capture_index+1; state<=S_COPY_FETCH_REQ; end
                end
                S_COPY_CLIP: begin
                    // Clip X completely, retain bounded X origins/count, then
                    // reuse the same signed interval for Y. No raw coordinate
                    // narrowing occurs until that axis has a nonempty interval.
                    case(copy_setup_step)
                    0,7: begin copy_high<=copy_raw_coordinate; copy_low<=0; end
                    1,2,3,4,8,9,10,11: copy_clip_held<=copy_clip_candidate;
                    5: copy_first_source_x<=copy_raw_coordinate+copy_low;
                    6: copy_first_destination_x<=copy_raw_coordinate+copy_low;
                    12: copy_first_source_y<=copy_raw_coordinate+copy_low;
                    13: copy_first_destination_y<=copy_raw_coordinate+copy_low;
                    default: raise_fault(9);
                    endcase
                    case(copy_setup_step)
                    1,2,3,4,8,9,10,11: state<=S_COPY_CLIP_CMP;
                    default: copy_clip_next();
                    endcase
                end
                S_COPY_CLIP_CMP: begin
                    if(copy_clip_better) begin
                        if(copy_clip_minimum) copy_high<=copy_clip_held;
                        else copy_low<=copy_clip_held;
                    end
                    copy_clip_next();
                end
                S_COPY_CLIP_CHECK: begin
                    if(copy_high<=copy_low) complete_command();
                    else begin
                        if(copy_setup_step==4) copy_count_x<=copy_high-copy_low;
                        else copy_count_y<=copy_high-copy_low;
                        copy_setup_step<=copy_setup_step+1;
                        capture_index<=copy_parameter_offset(copy_setup_step+4'd1); state<=S_COPY_FETCH_REQ;
                    end
                end
                S_COPY_INIT_PREP: begin
                    copy_reverse<=copy_should_reverse;
                    copy_destination_start_y_r<=copy_destination_start_y;
                    state<=S_COPY_INIT_ADDR;
                end
                S_COPY_INIT_ADDR: begin
                    if(copy_address_steps==0) begin
                        copy_row_number<=copy_reverse ? copy_count_y-11'd1 : 0;
                        copy_destination_row<=color_base(copy_target_id)+{3'd0,copy_destination_start_pixel,1'b0};
                        copy_address_steps<=1;
                    end else if(copy_address_steps-11'd1 < copy_source_start_y) begin
                        copy_source_row<=copy_source_row+copy_pitch; copy_address_steps<=copy_address_steps+1;
                    end else begin
                        copy_source_row<=copy_source_row+{11'd0,copy_first_source_x,1'b0};
                        copy_word<=0; copy_comp<=0; copy_active<=1;
                        color_valid[copy_target_id]<=0; state<=S_COPY_READ_CMD;
                    end
                end
                S_COPY_READ_CMD: if(mem_cmd_ready[5]) begin
                    copy_burst_end<=copy_word+{5'd0,copy_read_burst}; state<=S_COPY_READ_DATA;
                end
                S_COPY_READ_DATA: if(mem_r_valid[5]) begin
                    copy_prev<=copy_read_word; copy_word<=copy_word+1;
                    if(!copy_skip_compose) copy_comp<=copy_comp+1;
                    if(copy_word+1==copy_burst_end) state<=S_COPY_READ_DONE;
                end
                S_COPY_READ_DONE: if(mem_done[5]) begin
                    if(copy_word!=copy_src_words) state<=S_COPY_READ_CMD;
                    else begin
                        copy_word<=0;
                        state<=copy_comp!=copy_dst_words ? S_COPY_FLUSH : S_COPY_WRITE_CMD;
                    end
                end
                S_COPY_FLUSH: state<=S_COPY_WRITE_CMD;
                S_COPY_WRITE_CMD: if(mem_cmd_ready[5]) begin
                    copy_burst_end<=copy_word+{5'd0,copy_write_burst}; state<=S_COPY_PREFETCH;
                end
                S_COPY_PREFETCH: state<=S_COPY_WRITE_DATA;
                S_COPY_WRITE_DATA: if(mem_w_ready[5]) begin
                    copy_word<=copy_word+1;
                    if(copy_word+1==copy_burst_end) state<=S_COPY_WRITE_DONE;
                end
                S_COPY_WRITE_DONE: if(mem_done[5]) begin
                    if(copy_word!=copy_dst_words) state<=S_COPY_WRITE_CMD;
                    else if((!copy_reverse && copy_row_number+1==copy_count_y) || (copy_reverse && copy_row_number==0)) begin
                        color_valid[copy_target_id]<=copy_previous_valid ||
                            (copy_first_destination_x==0 && copy_first_destination_y==0 && copy_count_x==640 && copy_count_y==480);
                        copy_active<=0; complete_command();
                    end else begin
                        copy_row_number<=copy_reverse ? copy_row_number-1 : copy_row_number+1;
                        copy_source_row<=copy_reverse ? copy_source_row-copy_pitch : copy_source_row+copy_pitch;
                        copy_destination_row<=copy_reverse ? copy_destination_row-1280 : copy_destination_row+1280;
                        copy_word<=0; copy_comp<=0; state<=S_COPY_READ_CMD;
                    end
                end
                S_RECOVER: if(!host_abort && !host_recovering) begin
                    foreground_quiet<=0;
                    if(initialized) state<=S_IDLE; else state<=S_BOOT_WAIT;
                end
                S_FAULT: begin end
                default: raise_fault(9);
                endcase
            end
        end
    end

`ifndef SYNTHESIS
    // Check the storage optimization against a full execution-time snapshot in
    // simulation. This checker is absent from the synthesized circuit.
    reg [511:0] checked_status_snapshot;
    always @(posedge clk) begin
        if(reset) checked_status_snapshot<=0;
        else begin
            if(state==S_EXECUTE && opcode==2) checked_status_snapshot<=status_snapshot;
            if(state==S_REPLY && reply_has_snapshot && !reply_caps &&
               reply_index>=28 && reply_index<92 && response_ready &&
               !abort_pending && !fault_pending && host_fault==0 && !host_recovering)
                if(response_data !== checked_status_snapshot[(reply_index-28)*8 +:8])
                    $fatal(1,"GET_STATUS reply lost its execution-time snapshot");
        end
    end
`endif

    nano_host_link host_link (
        .clk(clk),.reset(reset),.host_clk(host_clk),.core_abort(host_abort),
        .host_wr_valid(host_wr_valid),.host_wr_data(host_wr_data),.host_wr_ready(host_wr_ready),.host_wr_ready_base(host_wr_ready_base),
        .host_rd_req(host_rd_req),.host_reg_addr(host_reg_addr),.host_rd_data(host_rd_data),.host_rd_valid(host_rd_valid),
        .status_snapshot(status_snapshot),.capabilities(capabilities),
        .cmd_valid(host_cmd_valid),.cmd_opcode(host_cmd_opcode),.cmd_sequence(host_cmd_sequence),.cmd_payload_length(host_cmd_length),
        .cmd_pop(host_cmd_pop),.payload_req(payload_req),.payload_offset(payload_offset),.payload_valid(payload_valid),.payload_data(payload_data),
        .response_valid(response_valid),.response_ready(response_ready),.response_data(response_data),.fault(host_fault),.recovering(host_recovering));
    nano_sdram_service #(.POWERUP_CYCLES(POWERUP_CYCLES),.REFRESH_INTERVAL(REFRESH_INTERVAL),
        .CAS_LATENCY(SDRAM_CAS_LATENCY),.T_RP(SDRAM_T_RP),.T_RCD(SDRAM_T_RCD),
        .T_RFC(SDRAM_T_RFC),.T_MRD(SDRAM_T_MRD),.T_WR(SDRAM_T_WR),
        .T_RAS(SDRAM_T_RAS),.T_RC(SDRAM_T_RC),
        .READ_TO_WRITE(SDRAM_READ_TO_WRITE),.WRITE_TO_READ(SDRAM_WRITE_TO_READ)) memory_service (
        .clk(clk),.reset(reset),.initialized(memory_initialized),
        .cmd_valid(mem_cmd_valid),.cmd_ready(mem_cmd_ready),.cmd_write(mem_cmd_write),.cmd_addr(mem_cmd_addr),.cmd_words(mem_cmd_words),
        .w_valid(mem_w_valid),.w_ready(mem_w_ready),.w_data(mem_w_data),.w_strb(mem_w_strb),
        .r_valid(mem_r_valid),.r_ready(mem_r_ready),.r_data(mem_r_data),.r_last(mem_r_last),.done(mem_done),.error(mem_error),
        .sd_clk(sd_clk),.sd_cke(sd_cke),.sd_cs_n(sd_cs_n),.sd_ras_n(sd_ras_n),.sd_cas_n(sd_cas_n),.sd_we_n(sd_we_n),
        .sd_ba(sd_ba),.sd_addr(sd_addr),.sd_dq_in(sd_dq_in),.sd_dq_out(sd_dq_out),.sd_dq_oe(sd_dq_oe),.sd_dqm(sd_dqm));
    nano_scanout scanout (
        .clk(clk),.reset(reset),.pixel_ce(pixel_tick),.memory_ready(initialized),.front_id(front_id),
        .pixel(video_rgb565),.hsync(video_hsync),.vsync(video_vsync),.de(video_de),.x(video_x),.y(video_y),
        .vblank_pulse(vblank_pulse),.underflows(scanout_underflows),
        .mem_cmd_valid(scan_cmd_valid),.mem_cmd_ready(mem_cmd_ready[0]),.mem_cmd_write(scan_cmd_write),
        .mem_cmd_addr(scan_cmd_addr),.mem_cmd_words(scan_cmd_words),.mem_w_valid(),.mem_w_ready(mem_w_ready[0]),.mem_w_data(),.mem_w_strb(),
        .mem_r_valid(mem_r_valid[0]),.mem_r_ready(scan_r_ready),.mem_r_data(mem_r_data[0 +:32]),.mem_r_last(mem_r_last[0]),
        .mem_done(mem_done[0]),.mem_error(mem_error[0]));
    nano_texture_cache texture_cache (
        .clk(clk),.reset(reset||renderer_reset),.flush(tex_flush),
        .cfg_valid(tex_cfg_valid),.cfg_ready(tex_cfg_ready),.cfg_base(tex_cfg_base),.cfg_width(tex_cfg_width),.cfg_height(tex_cfg_height),
        .cfg_pitch(tex_cfg_pitch),.cfg_repeat_u(tex_cfg_repeat_u),.cfg_repeat_v(tex_cfg_repeat_v),
        .req_valid(tex_req_valid),.req_ready(tex_req_ready),.req_x(tex_req_x),.req_y(tex_req_y),.req_tag(tex_req_tag),
        .rsp_valid(tex_rsp_valid),.rsp_ready(tex_rsp_ready),.rsp_texel(tex_rsp_texel),.rsp_tag(tex_rsp_tag),.fault(tex_fault),
        .mem_cmd_valid(tex_cmd_valid),.mem_cmd_ready(mem_cmd_ready[4]),.mem_cmd_write(tex_cmd_write),.mem_cmd_addr(tex_cmd_addr),.mem_cmd_words(tex_cmd_words),
        .mem_w_valid(tex_w_valid),.mem_w_ready(mem_w_ready[4]),.mem_w_data(tex_w_data),.mem_w_strb(tex_w_strb),
        .mem_r_valid(mem_r_valid[4]),.mem_r_ready(tex_r_ready),.mem_r_data(mem_r_data[128 +:32]),.mem_r_last(mem_r_last[4]),.mem_done(mem_done[4]),.mem_error(mem_error[4]));
    nano_triangle_setup triangle_setup (
        .clk(clk),.reset(reset||renderer_reset),
        .capture_we(record_load_valid && state==S_RECORD_DONE || record_load_valid && state==S_RECORD_DATA),
        .capture_index(record_load_index),.capture_data(record_load_data),
        .vertex_kind(setup_vertex),.start(state==S_SETUP && !setup_started),
        .tile_x(tile_origin_x),.tile_y(tile_origin_y),
        .word_we(setup_word_we),.word_index(setup_word_index),.word_data(setup_word_data),
        .done(setup_done),.draw(setup_draw),.bad(setup_bad));
    nano_tile_renderer tile_renderer (
        .clk(clk),.reset(reset||renderer_reset),.cmd_word_we(tile_cmd_word_we),.cmd_word_index(tile_cmd_word_index),.cmd_word_data(tile_cmd_word_data),
        .cmd_valid(tile_cmd_valid),.cmd_ready(tile_cmd_ready),.cmd_tile_x(tile_origin_x),.cmd_tile_y(tile_origin_y),
        .busy(tile_busy),.done(tile_done),.fault(tile_fault),
        .pix_we(tile_pix_we),.pix_addr(tile_pix_addr),.pix_color(tile_pix_color),.pix_depth(tile_pix_depth),
        .pix_re(tile_pix_re),.pix_raddr(tile_pix_raddr),.pix_rvalid(tile_pix_rvalid),.pix_rcolor(tile_pix_rcolor),.pix_rdepth(tile_pix_rdepth),
        .tex_flush(tex_flush),.tex_cfg_valid(tex_cfg_valid),.tex_cfg_ready(tex_cfg_ready),.tex_cfg_base(tex_cfg_base),
        .tex_cfg_width(tex_cfg_width),.tex_cfg_height(tex_cfg_height),.tex_cfg_pitch(tex_cfg_pitch),.tex_cfg_repeat_u(tex_cfg_repeat_u),.tex_cfg_repeat_v(tex_cfg_repeat_v),
        .tex_req_valid(tex_req_valid),.tex_req_ready(tex_req_ready),.tex_req_x(tex_req_x),.tex_req_y(tex_req_y),.tex_req_tag(tex_req_tag),
        .tex_rsp_valid(tex_rsp_valid),.tex_rsp_ready(tex_rsp_ready),.tex_rsp_texel(tex_rsp_texel),.tex_rsp_tag(tex_rsp_tag),.tex_fault(tex_fault));
    nano_sdp16 reply_ram (.wclk(clk),.wce(1'b1),.we(reply_ram_we),.waddr(reply_ram_waddr),.wdata(reply_ram_wdata),
        .rclk(clk),.rce(1'b1),.re(reply_ram_re),.raddr(reply_ram_raddr),.reset_output(reset),.rdata(reply_ram_rdata));
    nano_sdp32 copy_row_ram (.wclk(clk),.wce(1'b1),.we(copy_ram_we),.waddr(copy_ram_waddr),.wdata(copy_ram_wdata),
        .rclk(clk),.rce(1'b1),.re(copy_ram_re),.raddr(copy_ram_raddr),.reset_output(reset),.rdata(copy_ram_rdata));
    nano_sdp16 upload_ram (.wclk(clk),.wce(1'b1),.we(upload_ram_we),.waddr(upload_ram_waddr),.wdata(upload_ram_wdata),
        .rclk(clk),.rce(1'b1),.re(upload_ram_re),.raddr(upload_ram_raddr),.reset_output(reset),.rdata(upload_ram_rdata));
endmodule
