apc53pro/Nano-20K-GPU/reference/src/hw_protocol.cpp

#include "nano_gpu/hw/protocol.hpp"

#include <algorithm>
#include <limits>
#include <stdexcept>
#include <type_traits>
#include <unordered_map>

namespace nano_gpu::hw {
namespace {

void require_size(const std::vector<std::uint8_t>& bytes, std::size_t size) {
    if (bytes.size() != size) throw std::invalid_argument("incorrect packed structure size");
}
void require_field(const std::vector<std::uint8_t>& bytes, std::size_t offset, std::size_t size) {
    if (offset > bytes.size() || size > bytes.size() - offset)
        throw std::out_of_range("packed field exceeds byte buffer");
}
void require_zero(const std::vector<std::uint8_t>& bytes, std::size_t begin, std::size_t end) {
    if (std::any_of(bytes.begin() + static_cast<std::ptrdiff_t>(begin),
                    bytes.begin() + static_cast<std::ptrdiff_t>(end),
                    [](std::uint8_t value) { return value != 0; }))
        throw std::invalid_argument("nonzero reserved packed field");
}
bool known_opcode(Opcode opcode) {
    const auto code = static_cast<unsigned>(opcode);
    return code >= static_cast<unsigned>(Opcode::GetCaps) && code <= static_cast<unsigned>(Opcode::ReadMemory);
}
bool power_of_two(std::uint32_t value) { return value != 0 && (value & (value - 1)) == 0; }
void require_texture(const TextureDescriptor& texture) {
    texture_extent(texture);
    if (!power_of_two(texture.width) || !power_of_two(texture.height))
        throw std::invalid_argument("bound texture dimensions must be powers of two");
}
void put_bounds(std::vector<std::uint8_t>& bytes, std::size_t at, Bounds bounds) {
    write_i32(bytes, at, bounds.x0); write_i32(bytes, at + 4, bounds.y0);
    write_i32(bytes, at + 8, bounds.x1); write_i32(bytes, at + 12, bounds.y1);
}
Bounds get_bounds(const std::vector<std::uint8_t>& bytes, std::size_t at) {
    return {read_i32(bytes, at), read_i32(bytes, at + 4),
            read_i32(bytes, at + 8), read_i32(bytes, at + 12)};
}
void put_texture(std::vector<std::uint8_t>& bytes, std::size_t at, const TextureDescriptor& texture) {
    write_u32(bytes, at, texture.base); write_u32(bytes, at + 4, texture.width);
    write_u32(bytes, at + 8, texture.height); write_u32(bytes, at + 12, texture.pitch_bytes);
}
TextureDescriptor get_texture(const std::vector<std::uint8_t>& bytes, std::size_t at) {
    return {read_u32(bytes, at), read_u32(bytes, at + 4),
            read_u32(bytes, at + 8), read_u32(bytes, at + 12)};
}
void validate_state_fields(const RenderState& state) {
    if (static_cast<unsigned>(state.shade) > static_cast<unsigned>(ShadeMode::TextureGouraudModulate) ||
        static_cast<unsigned>(state.depth_func) > static_cast<unsigned>(DepthFunc::Always) ||
        static_cast<unsigned>(state.address_u) > static_cast<unsigned>(AddressMode::Repeat) ||
        static_cast<unsigned>(state.address_v) > static_cast<unsigned>(AddressMode::Repeat))
        throw std::invalid_argument("unsupported packed render state");
}
bool needs_texture(const Primitive& primitive) {
    return std::visit([](const auto& item) {
        using T = std::decay_t<decltype(item)>;
        if constexpr (std::is_same_v<T, Sprite>) return true;
        else if constexpr (std::is_same_v<T, Triangle>)
            return static_cast<unsigned>(item.state.shade) >= static_cast<unsigned>(ShadeMode::TextureReplace) &&
                   (item.state.color_write || item.state.color_key.has_value());
        else return false;
    }, primitive);
}
void validate_primitive(const Primitive& primitive) {
    std::visit([&](const auto& item) {
        using T = std::decay_t<decltype(item)>;
        validate_state_fields(item.state);
        if constexpr (std::is_same_v<T, Triangle>) validate_triangle(item);
        else {
            // This encoder is CPU code. Validate inputs without instantiating
            // a clocked C++ GPU walker, so the RTL host/oracle binary need not
            // link any C++ device implementation.
            if (item.depth > depth_max) throw std::invalid_argument("2D constant depth exceeds D24");
            if constexpr (std::is_same_v<T, Sprite>) {
                if ((item.state.shade != ShadeMode::Flat && item.state.shade != ShadeMode::TextureReplace) ||
                    !item.state.texture || !item.state.texture->texture_compatible())
                    throw std::invalid_argument("sprite requires raw replacement and a compatible texture");
                if (item.source_x < 0 || item.source_y < 0)
                    throw std::invalid_argument("negative sprite source origin");
                const auto width = static_cast<std::int64_t>(item.bounds.x1) - item.bounds.x0;
                const auto height = static_cast<std::int64_t>(item.bounds.y1) - item.bounds.y0;
                if (!item.bounds.empty() &&
                    (static_cast<std::int64_t>(item.source_x) + width > item.state.texture->width() ||
                     static_cast<std::int64_t>(item.source_y) + height > item.state.texture->height()))
                    throw std::invalid_argument("sprite source rectangle exceeds texture");
            } else {
                if (item.state.shade != ShadeMode::Flat || item.state.color_key)
                    throw std::invalid_argument("rectangle/line requires flat unkeyed color");
                if constexpr (std::is_same_v<T, Line>) {
                    if (!Bounds{}.contains(item.a.x, item.a.y) || !Bounds{}.contains(item.b.x, item.b.y))
                        throw std::invalid_argument("line endpoints must be viewport-clipped");
                }
            }
        }
    }, primitive);
}
void validate_pass(const PassDescriptor& descriptor) {
    if (descriptor.target < 0 || descriptor.target > 1 || descriptor.clear_depth > depth_max ||
        (descriptor.color_load != LoadOp::Load && descriptor.color_load != LoadOp::Clear) ||
        (descriptor.depth_load != LoadOp::Load && descriptor.depth_load != LoadOp::Clear) ||
        (descriptor.depth_store != StoreOp::Store && descriptor.depth_store != StoreOp::Discard))
        throw std::invalid_argument("invalid packed pass state");
    validate_heap_range(descriptor.tile_table_address, tile_count * tile_entry_bytes);
}

class HeapBuilder {
public:
    explicit HeapBuilder(std::uint32_t base_address = heap_base) : base(base_address) {
        if (base < heap_base || base > memory_bytes || (base & 3u) != 0)
            throw std::invalid_argument("compiled heap has invalid base");
    }
    std::uint32_t allocate(std::uint64_t size) {
        if (size == 0 || (size & 3u) != 0 || size > memory_bytes - base ||
            bytes.size() > memory_bytes - base - size)
            throw std::invalid_argument("compiled pass exceeds the shared GPU heap");
        const auto address = base + static_cast<std::uint32_t>(bytes.size());
        bytes.resize(bytes.size() + static_cast<std::size_t>(size), 0);
        return address;
    }
    void put(std::uint32_t address, const std::vector<std::uint8_t>& source) {
        const auto offset = static_cast<std::size_t>(address - base);
        require_field(bytes, offset, source.size());
        std::copy(source.begin(), source.end(), bytes.begin() + static_cast<std::ptrdiff_t>(offset));
    }
    std::uint32_t base;
    std::vector<std::uint8_t> bytes;
};

} // namespace

std::uint16_t read_u16(const std::vector<std::uint8_t>& bytes, std::size_t offset) {
    require_field(bytes, offset, 2);
    return static_cast<std::uint16_t>(bytes[offset] | (static_cast<std::uint16_t>(bytes[offset + 1]) << 8));
}
std::uint32_t read_u32(const std::vector<std::uint8_t>& bytes, std::size_t offset) {
    require_field(bytes, offset, 4);
    std::uint32_t value = 0;
    for (unsigned i = 0; i < 4; ++i) value |= static_cast<std::uint32_t>(bytes[offset + i]) << (8 * i);
    return value;
}
std::int32_t read_i32(const std::vector<std::uint8_t>& bytes, std::size_t offset) {
    const auto value = read_u32(bytes, offset);
    if (value <= static_cast<std::uint32_t>(std::numeric_limits<std::int32_t>::max()))
        return static_cast<std::int32_t>(value);
    return -1 - static_cast<std::int32_t>(~value);
}
std::int64_t read_i64(const std::vector<std::uint8_t>& bytes, std::size_t offset) {
    require_field(bytes, offset, 8);
    const auto value = static_cast<std::uint64_t>(read_u32(bytes, offset)) |
                       (static_cast<std::uint64_t>(read_u32(bytes, offset + 4)) << 32);
    if (value <= static_cast<std::uint64_t>(std::numeric_limits<std::int64_t>::max()))
        return static_cast<std::int64_t>(value);
    return -1 - static_cast<std::int64_t>(~value);
}
void write_u16(std::vector<std::uint8_t>& bytes, std::size_t offset, std::uint16_t value) {
    require_field(bytes, offset, 2);
    bytes[offset] = static_cast<std::uint8_t>(value);
    bytes[offset + 1] = static_cast<std::uint8_t>(value >> 8);
}
void write_u32(std::vector<std::uint8_t>& bytes, std::size_t offset, std::uint32_t value) {
    require_field(bytes, offset, 4);
    for (unsigned i = 0; i < 4; ++i) bytes[offset + i] = static_cast<std::uint8_t>(value >> (8 * i));
}
void write_i32(std::vector<std::uint8_t>& bytes, std::size_t offset, std::int32_t value) {
    write_u32(bytes, offset, static_cast<std::uint32_t>(value));
}
void write_i64(std::vector<std::uint8_t>& bytes, std::size_t offset, std::int64_t value) {
    const auto bits = static_cast<std::uint64_t>(value);
    write_u32(bytes, offset, static_cast<std::uint32_t>(bits));
    write_u32(bytes, offset + 4, static_cast<std::uint32_t>(bits >> 32));
}

void validate_heap_range(std::uint32_t address, std::uint64_t length, unsigned alignment) {
    if (alignment == 0 || (alignment & (alignment - 1)) != 0 || address % alignment != 0 ||
        address < heap_base || address >= memory_bytes || length == 0 || length > memory_bytes ||
        static_cast<std::uint64_t>(address) + length > memory_bytes)
        throw std::invalid_argument("packed address is outside an aligned live heap extent");
}
std::uint32_t texture_extent(const TextureDescriptor& texture) {
    if (texture.width < 1 || texture.width > 1024 || texture.height < 1 || texture.height > 1024 ||
        texture.pitch_bytes < 2u * texture.width || (texture.pitch_bytes & 3u) != 0)
        throw std::invalid_argument("invalid packed image dimensions or pitch");
    const auto extent = static_cast<std::uint64_t>(texture.pitch_bytes) * texture.height;
    validate_heap_range(texture.base, extent);
    return static_cast<std::uint32_t>(extent);
}

std::vector<std::uint8_t> encode_packet(Opcode opcode, std::uint32_t sequence,
                                       const std::vector<std::uint8_t>& payload) {
    if (!known_opcode(opcode) || sequence == 0 || payload.size() > maximum_packet_payload)
        throw std::invalid_argument("invalid provisional NGPU packet");
    std::vector<std::uint8_t> result(packet_header_bytes + payload.size(), 0);
    result[0] = 'N'; result[1] = 'G'; result[2] = 'P'; result[3] = 'U';
    result[4] = protocol_major; result[5] = protocol_minor;
    write_u16(result, 6, static_cast<std::uint16_t>(opcode));
    write_u32(result, 8, static_cast<std::uint32_t>(payload.size()));
    write_u32(result, 12, sequence);
    std::copy(payload.begin(), payload.end(), result.begin() + packet_header_bytes);
    return result;
}

std::vector<std::uint8_t> encode_heap_upload(std::uint32_t address,
                                          const std::vector<std::uint8_t>& bytes) {
    if (bytes.empty() || bytes.size() > maximum_upload_decoded_bytes)
        throw std::invalid_argument("encoded heap upload decoded length");
    validate_heap_range(address, bytes.size(), 1);
    std::vector<std::uint8_t> payload(8, 0);
    write_u32(payload, 0, address);
    write_u32(payload, 4, static_cast<std::uint32_t>(bytes.size()));
    for (std::size_t group = 0; group < bytes.size(); group += 16) {
        const auto descriptor = payload.size();
        payload.push_back(0);
        for (unsigned slot = 0; slot < 4 && group + 4 * slot < bytes.size(); ++slot) {
            const auto offset = group + 4 * slot;
            std::uint32_t word = 0;
            for (unsigned byte = 0; byte < 4 && offset + byte < bytes.size(); ++byte)
                word |= static_cast<std::uint32_t>(bytes[offset + byte]) << (8 * byte);
            const unsigned code = word == 0 ? 0 :
                ((word & 0xffffff00u) == ((word & 0x80u) ? 0xffffff00u : 0)) ? 1 :
                ((word & 0xffff0000u) == ((word & 0x8000u) ? 0xffff0000u : 0)) ? 2 : 3;
            payload[descriptor] |= static_cast<std::uint8_t>(code << (2 * slot));
            const unsigned count = code == 3 ? 4 : code;
            for (unsigned byte = 0; byte < count; ++byte)
                payload.push_back(static_cast<std::uint8_t>(word >> (8 * byte)));
        }
    }
    if (payload.size() > maximum_packet_payload)
        throw std::logic_error("encoded heap upload exceeds fixed packet storage");
    return payload;
}

HeapUpload decode_heap_upload(const std::vector<std::uint8_t>& payload) {
    if (payload.size() <= 8 || payload.size() > maximum_packet_payload)
        throw std::invalid_argument("encoded heap upload payload length");
    HeapUpload result;
    result.address = read_u32(payload, 0);
    const auto length = read_u32(payload, 4);
    if (length == 0 || length > maximum_upload_decoded_bytes)
        throw std::invalid_argument("encoded heap upload decoded length");
    validate_heap_range(result.address, length, 1);
    result.bytes.reserve(length);
    std::size_t cursor = 8;
    while (result.bytes.size() < length) {
        if (cursor == payload.size())
            throw std::invalid_argument("truncated heap upload descriptor");
        unsigned descriptor = payload[cursor++];
        for (unsigned slot = 0; slot < 4 && result.bytes.size() < length; ++slot) {
            const unsigned code = descriptor & 3u;
            descriptor >>= 2;
            const unsigned count = code == 3 ? 4 : code;
            if (count > payload.size() - cursor)
                throw std::invalid_argument("truncated heap upload word");
            std::uint32_t word = 0;
            for (unsigned byte = 0; byte < count; ++byte)
                word |= static_cast<std::uint32_t>(payload[cursor++]) << (8 * byte);
            if (code == 1 && (word & 0x80u)) word |= 0xffffff00u;
            if (code == 2 && (word & 0x8000u)) word |= 0xffff0000u;
            for (unsigned byte = 0; byte < 4 && result.bytes.size() < length; ++byte)
                result.bytes.push_back(static_cast<std::uint8_t>(word >> (8 * byte)));
        }
        if (result.bytes.size() == length && descriptor != 0)
            throw std::invalid_argument("nonzero unused heap upload codes");
    }
    if (cursor != payload.size())
        throw std::invalid_argument("trailing encoded heap upload bytes");
    return result;
}

std::size_t record_bytes(const Primitive& primitive) {
    const auto* triangle = std::get_if<Triangle>(&primitive);
    return triangle && triangle->source ? vertex_triangle_record_bytes : primitive_record_bytes;
}

std::size_t record_bytes_for_kind(std::uint32_t first_word) {
    return (first_word & 0xffu) == 4 ? vertex_triangle_record_bytes : primitive_record_bytes;
}

std::vector<std::uint8_t> encode_vertex_triangle(const VertexSource& source, const RenderState& state) {
    validate_state_fields(state);
    (void)vertex_triangle_setup(source, state); // Validates fields and the resulting setup.
    std::vector<std::uint8_t> result(vertex_triangle_record_bytes, 0);
    const auto flags = (state.color_write ? 1u : 0u) | (state.depth_test ? 2u : 0u) |
                       (state.depth_write ? 4u : 0u);
    write_u32(result, 0, 4u | 0x100u | (flags << 16) | (source.cull_negative ? 1u << 20 : 0u));
    write_u32(result, 4, static_cast<std::uint32_t>(state.depth_func) << 8);
    write_u32(result, 8, state.color.r | (static_cast<std::uint32_t>(state.color.g) << 8) |
                           (static_cast<std::uint32_t>(state.color.b) << 16));
    for (unsigned i = 0; i < 3; ++i) {
        write_u32(result, 12 + 4 * i, static_cast<std::uint32_t>(source.points[i].x) |
                                      (static_cast<std::uint32_t>(source.points[i].y) << 16));
        write_u32(result, 24 + 4 * i, source.depth[i]);
    }
    write_u32(result, 36, static_cast<std::uint32_t>(source.bounds.x0) |
                          (static_cast<std::uint32_t>(source.bounds.x1) << 16));
    write_u32(result, 40, static_cast<std::uint32_t>(source.bounds.y0) |
                          (static_cast<std::uint32_t>(source.bounds.y1) << 16));
    return result;
}

std::vector<std::uint8_t> encode_primitive(const Primitive& primitive,
                                         std::optional<TextureDescriptor> texture) {
    validate_primitive(primitive);
    if (const auto* triangle = std::get_if<Triangle>(&primitive); triangle && triangle->source) {
        if (texture) throw std::invalid_argument("vertex triangle cannot carry a texture");
        return encode_vertex_triangle(*triangle->source, triangle->state);
    }
    if (needs_texture(primitive) && !texture)
        throw std::invalid_argument("packed textured primitive needs a GPU texture descriptor");
    if (texture) require_texture(*texture);
    std::vector<std::uint8_t> result(primitive_record_bytes, 0);
    std::visit([&](const auto& item) {
        using T = std::decay_t<decltype(item)>;
        const auto& state = item.state;
        const auto flags = (state.color_write ? 1u : 0u) | (state.depth_test ? 2u : 0u) |
                           (state.depth_write ? 4u : 0u) | (state.color_key ? 8u : 0u);
        write_u32(result, 0, static_cast<std::uint32_t>(primitive.index()) | 0x100u | (flags << 16));
        write_u32(result, 4, static_cast<std::uint32_t>(state.shade) |
            (static_cast<std::uint32_t>(state.depth_func) << 8) |
            (state.address_u == AddressMode::Repeat ? 1u << 16 : 0u) |
            (state.address_v == AddressMode::Repeat ? 1u << 17 : 0u) |
            (texture ? 1u << 18 : 0u));
        write_u32(result, 8, state.color.r | (static_cast<std::uint32_t>(state.color.g) << 8) |
                               (static_cast<std::uint32_t>(state.color.b) << 16));
        write_u32(result, 12, state.color_key.value_or(0));
        put_bounds(result, 16, state.scissor);
        if (texture) {
            if (state.texture && (texture->width != static_cast<unsigned>(state.texture->width()) ||
                texture->height != static_cast<unsigned>(state.texture->height()) ||
                texture->pitch_bytes != static_cast<unsigned>(state.texture->pitch_bytes())))
                throw std::invalid_argument("packed texture descriptor differs from bound image");
            put_texture(result, 48, *texture);
        }
        if constexpr (std::is_same_v<T, Triangle>) {
            put_bounds(result, 32, item.bounds);
            for (unsigned i = 0; i < 3; ++i) {
                write_i32(result, 80 + 8 * i, item.snapped[i].x);
                write_i32(result, 84 + 8 * i, item.snapped[i].y);
                write_i32(result, 104 + 16 * i, item.edges[i].a);
                write_i32(result, 108 + 16 * i, item.edges[i].b);
                write_i32(result, 112 + 16 * i, item.edges[i].c);
                write_u32(result, 116 + 16 * i, item.edges[i].inclusive ? 1u : 0u);
            }
            const std::array<Plane, 7> planes{item.z, item.r, item.g, item.b, item.q, item.u, item.v};
            for (unsigned i = 0; i < planes.size(); ++i) {
                write_i64(result, 152 + 24 * i, planes[i].seed);
                write_i64(result, 160 + 24 * i, planes[i].step_x);
                write_i64(result, 168 + 24 * i, planes[i].step_y);
            }
        } else {
            write_u32(result, 64, item.depth);
            if constexpr (std::is_same_v<T, Line>) {
                write_i32(result, 68, item.a.x); write_i32(result, 72, item.a.y);
                write_i32(result, 80, item.b.x); write_i32(result, 84, item.b.y);
            } else {
                put_bounds(result, 32, item.bounds);
                if constexpr (std::is_same_v<T, Sprite>) {
                    write_i32(result, 68, item.source_x); write_i32(result, 72, item.source_y);
                }
            }
        }
    }, primitive);
    return result;
}

namespace {
DecodedPrimitive decode_vertex_triangle(const std::vector<std::uint8_t>& bytes) {
    require_size(bytes, vertex_triangle_record_bytes);
    const auto kind_flags = read_u32(bytes, 0);
    const auto modes = read_u32(bytes, 4);
    if (((kind_flags >> 8) & 0xffu) != 1 || (kind_flags & 0xffe80000u) != 0 ||
        (modes & ~0x300u) != 0 || ((modes >> 8) & 3u) == 3 || (read_u32(bytes, 8) & 0xff000000u) != 0)
        throw std::invalid_argument("invalid vertex triangle fields");
    for (unsigned i = 0; i < 3; ++i)
        if ((read_u32(bytes, 12 + 4 * i) & 0xe000c000u) != 0)
            throw std::invalid_argument("vertex triangle position outside 14/13-bit Q4");
    for (unsigned offset = 36; offset <= 40; offset += 4)
        if ((read_u32(bytes, offset) & 0xf800f800u) != 0)
            throw std::invalid_argument("vertex triangle bounds outside 11 bits");
    require_zero(bytes, 44, vertex_triangle_record_bytes);
    RenderState state;
    state.color_write = (kind_flags & (1u << 16)) != 0;
    state.depth_test = (kind_flags & (1u << 17)) != 0;
    state.depth_write = (kind_flags & (1u << 18)) != 0;
    state.depth_func = static_cast<DepthFunc>((modes >> 8) & 3u);
    const auto rgb = read_u32(bytes, 8);
    state.color = {static_cast<std::uint8_t>(rgb), static_cast<std::uint8_t>(rgb >> 8),
                   static_cast<std::uint8_t>(rgb >> 16)};
    VertexSource source;
    source.cull_negative = (kind_flags & (1u << 20)) != 0;
    for (unsigned i = 0; i < 3; ++i) {
        const auto position = read_u32(bytes, 12 + 4 * i);
        source.points[i] = {static_cast<int>(position & 0xffffu), static_cast<int>(position >> 16)};
        source.depth[i] = read_u32(bytes, 24 + 4 * i);
    }
    source.bounds = {static_cast<int>(read_u32(bytes, 36) & 0xffffu), static_cast<int>(read_u32(bytes, 40) & 0xffffu),
                     static_cast<int>(read_u32(bytes, 36) >> 16), static_cast<int>(read_u32(bytes, 40) >> 16)};
    DecodedPrimitive result;
    if (auto triangle = vertex_triangle_setup(source, state)) result.primitive = *triangle;
    else { result.primitive = Rect{{0, 0, 0, 0}, overlay_state(), 0}; result.draws = false; }
    return result;
}
} // namespace

DecodedPrimitive decode_primitive(const std::vector<std::uint8_t>& bytes) {
    if (bytes.size() >= 4 && (read_u32(bytes, 0) & 0xffu) == 4) return decode_vertex_triangle(bytes);
    require_size(bytes, primitive_record_bytes);
    const auto kind_flags = read_u32(bytes, 0);
    const unsigned kind = kind_flags & 0xffu;
    if (kind > 3 || ((kind_flags >> 8) & 0xffu) != 1 || (kind_flags & 0xfff00000u) != 0)
        throw std::invalid_argument("unsupported primitive kind, version, or flags");
    const auto modes = read_u32(bytes, 4);
    if ((modes & 0xfff80000u) != 0 || (modes & 0xffu) > 4 || ((modes >> 8) & 0xffu) > 2 ||
        (read_u32(bytes, 8) & 0xff000000u) != 0 || (read_u32(bytes, 12) & 0xffff0000u) != 0)
        throw std::invalid_argument("invalid packed primitive state or reserved bits");
    RenderState state;
    state.color_write = (kind_flags & (1u << 16)) != 0;
    state.depth_test = (kind_flags & (1u << 17)) != 0;
    state.depth_write = (kind_flags & (1u << 18)) != 0;
    if ((kind_flags & (1u << 19)) != 0) state.color_key = read_u16(bytes, 12);
    else if (read_u32(bytes, 12) != 0) throw std::invalid_argument("disabled color key must be zero");
    state.shade = static_cast<ShadeMode>(modes & 0xffu);
    state.depth_func = static_cast<DepthFunc>((modes >> 8) & 0xffu);
    state.address_u = (modes & (1u << 16)) != 0 ? AddressMode::Repeat : AddressMode::Clamp;
    state.address_v = (modes & (1u << 17)) != 0 ? AddressMode::Repeat : AddressMode::Clamp;
    const auto rgb = read_u32(bytes, 8);
    state.color = {static_cast<std::uint8_t>(rgb), static_cast<std::uint8_t>(rgb >> 8),
                   static_cast<std::uint8_t>(rgb >> 16)};
    state.scissor = get_bounds(bytes, 16);
    DecodedPrimitive result;
    if ((modes & (1u << 18)) != 0) {
        result.texture = get_texture(bytes, 48);
        require_texture(*result.texture);
        state.texture = Image::descriptor(static_cast<int>(result.texture->width),
            static_cast<int>(result.texture->height), static_cast<int>(result.texture->pitch_bytes));
    } else require_zero(bytes, 48, 64);
    require_zero(bytes, 76, 80);
    if (kind == 0) {
        require_zero(bytes, 64, 76);
        Triangle triangle;
        triangle.state = state; triangle.bounds = get_bounds(bytes, 32);
        for (unsigned i = 0; i < 3; ++i) {
            triangle.snapped[i] = {read_i32(bytes, 80 + 8 * i), read_i32(bytes, 84 + 8 * i)};
            const auto inclusive = read_u32(bytes, 116 + 16 * i);
            if (inclusive > 1) throw std::invalid_argument("invalid edge inclusion bit");
            triangle.edges[i] = {read_i32(bytes, 104 + 16 * i), read_i32(bytes, 108 + 16 * i),
                                 read_i32(bytes, 112 + 16 * i), inclusive != 0};
        }
        const std::array<Plane*, 7> planes{&triangle.z, &triangle.r, &triangle.g, &triangle.b,
                                          &triangle.q, &triangle.u, &triangle.v};
        for (unsigned i = 0; i < planes.size(); ++i)
            *planes[i] = {read_i64(bytes, 152 + 24 * i), read_i64(bytes, 160 + 24 * i),
                           read_i64(bytes, 168 + 24 * i)};
        result.primitive = triangle;
    } else {
        const auto depth = read_u32(bytes, 64);
        if (depth > depth_max) throw std::invalid_argument("packed constant depth exceeds D24");
        if (kind == 1) {
            require_zero(bytes, 68, 76); require_zero(bytes, 80, primitive_record_bytes);
            result.primitive = Rect{get_bounds(bytes, 32), state, depth};
        } else if (kind == 2) {
            require_zero(bytes, 32, 48); require_zero(bytes, 88, primitive_record_bytes);
            result.primitive = Line{{read_i32(bytes, 68), read_i32(bytes, 72)},
                                     {read_i32(bytes, 80), read_i32(bytes, 84)}, state, depth};
        } else {
            require_zero(bytes, 80, primitive_record_bytes);
            result.primitive = Sprite{get_bounds(bytes, 32), read_i32(bytes, 68), read_i32(bytes, 72), state, depth};
        }
    }
    if (needs_texture(result.primitive) && !result.texture)
        throw std::invalid_argument("packed primitive is missing its texture descriptor");
    validate_primitive(result.primitive);
    return result;
}

std::vector<std::uint8_t> encode_pass_descriptor(const PassDescriptor& descriptor) {
    validate_pass(descriptor);
    std::vector<std::uint8_t> result(pass_descriptor_bytes, 0);
    write_u32(result, 0, pass_descriptor_magic);
    write_u32(result, 4, static_cast<std::uint32_t>(descriptor.target));
    write_u32(result, 8, (descriptor.color_load == LoadOp::Clear ? 1u : 0u) |
                          (descriptor.depth_load == LoadOp::Clear ? 2u : 0u) |
                          (descriptor.depth_store == StoreOp::Discard ? 4u : 0u) |
                          (descriptor.skip_empty_tiles ? 8u : 0u));
    write_u32(result, 12, descriptor.clear_color); write_u32(result, 16, descriptor.clear_depth);
    write_u32(result, 20, descriptor.tile_table_address); write_u32(result, 24, tile_count);
    return result;
}
PassDescriptor decode_pass_descriptor(const std::vector<std::uint8_t>& bytes) {
    require_size(bytes, pass_descriptor_bytes);
    if (read_u32(bytes, 0) != pass_descriptor_magic || read_u32(bytes, 4) > 1 ||
        (read_u32(bytes, 8) & ~15u) != 0 || read_u32(bytes, 12) > 0xffffu ||
        read_u32(bytes, 16) > depth_max || read_u32(bytes, 24) != tile_count || read_u32(bytes, 28) != 0)
        throw std::invalid_argument("invalid pass descriptor fields");
    PassDescriptor result;
    result.target = static_cast<int>(read_u32(bytes, 4));
    result.color_load = (read_u32(bytes, 8) & 1u) ? LoadOp::Clear : LoadOp::Load;
    result.depth_load = (read_u32(bytes, 8) & 2u) ? LoadOp::Clear : LoadOp::Load;
    result.depth_store = (read_u32(bytes, 8) & 4u) ? StoreOp::Discard : StoreOp::Store;
    result.skip_empty_tiles = (read_u32(bytes, 8) & 8u) != 0;
    result.clear_color = read_u16(bytes, 12); result.clear_depth = read_u32(bytes, 16);
    result.tile_table_address = read_u32(bytes, 20);
    validate_pass(result);
    return result;
}
TileEntry decode_tile_entry(const std::vector<std::uint8_t>& bytes) {
    require_size(bytes, tile_entry_bytes);
    TileEntry result{read_u32(bytes, 0), read_u32(bytes, 4)};
    if (result.count > maximum_pass_references || (result.count == 0 && result.address != 0))
        throw std::invalid_argument("invalid tile list count or empty-list address");
    if (result.count != 0) validate_heap_range(result.address, 4ull * result.count);
    return result;
}

std::vector<std::uint8_t> encode_copy_command(const CopyCommand& command) {
    if (command.target < 0 || command.target > 1 || command.source < 0 || command.source > 1 ||
        command.width < 0 || command.height < 0 || (command.image_source && command.source != 0))
        throw std::invalid_argument("invalid copy command state");
    if (command.image_source) texture_extent(command.image);
    else if (command.image != TextureDescriptor{}) throw std::invalid_argument("framebuffer copy has image metadata");
    std::vector<std::uint8_t> result(copy_payload_bytes, 0);
    write_u32(result, 0, command.image_source ? 1u : 0u);
    write_u32(result, 4, static_cast<std::uint32_t>(command.source));
    write_u32(result, 8, static_cast<std::uint32_t>(command.target));
    write_i32(result, 12, command.source_origin.x); write_i32(result, 16, command.source_origin.y);
    write_i32(result, 20, command.destination_origin.x); write_i32(result, 24, command.destination_origin.y);
    write_i32(result, 28, command.width); write_i32(result, 32, command.height);
    if (command.image_source) put_texture(result, 36, command.image);
    return result;
}
CopyCommand decode_copy_command(const std::vector<std::uint8_t>& bytes) {
    require_size(bytes, copy_payload_bytes);
    if (read_u32(bytes, 0) > 1 || read_u32(bytes, 4) > 1 || read_u32(bytes, 8) > 1 || read_u32(bytes, 52) != 0)
        throw std::invalid_argument("invalid copy command fields");
    CopyCommand result;
    result.image_source = read_u32(bytes, 0) != 0;
    result.source = static_cast<int>(read_u32(bytes, 4)); result.target = static_cast<int>(read_u32(bytes, 8));
    result.source_origin = {read_i32(bytes, 12), read_i32(bytes, 16)};
    result.destination_origin = {read_i32(bytes, 20), read_i32(bytes, 24)};
    result.width = read_i32(bytes, 28); result.height = read_i32(bytes, 32);
    result.image = get_texture(bytes, 36);
    encode_copy_command(result); // Same bounded validation for producer and consumer.
    return result;
}

namespace {

struct Upload {
    std::uint32_t address;
    std::shared_ptr<const std::vector<std::uint8_t>> bytes;
};

std::shared_ptr<const std::vector<std::uint8_t>> texture_pixels(const Image& image) {
    const auto extent = static_cast<std::uint64_t>(image.pitch_bytes()) * image.height();
    if (extent > memory_bytes - heap_base)
        throw std::invalid_argument("texture exceeds the shared GPU heap");
    auto bytes = std::make_shared<std::vector<std::uint8_t>>(static_cast<std::size_t>(extent), 0);
    for (int y = 0; y < image.height(); ++y) for (int x = 0; x < image.width(); ++x)
        write_u16(*bytes, static_cast<std::size_t>(y) * image.pitch_bytes() + 2u * x, image.at(x, y));
    return bytes;
}

void require_program(const Pass& pass, std::uint32_t first_sequence) {
    if (first_sequence == 0 || pass.primitives.size() > maximum_primitive_records)
        throw std::invalid_argument("invalid first sequence or too many primitive records");
    for (const auto& primitive : pass.primitives) validate_primitive(primitive);
}

HostProgram build_pass_heap(const Pass& pass, const TileBins& bins,
        const std::vector<std::optional<TextureDescriptor>>& bindings, HeapBuilder& heap) {
    std::vector<std::uint32_t> records;
    records.reserve(pass.primitives.size());
    for (std::size_t index = 0; index < pass.primitives.size(); ++index) {
        const auto address = heap.allocate(record_bytes(pass.primitives[index]));
        heap.put(address, encode_primitive(pass.primitives[index], bindings[index]));
        records.push_back(address);
    }
    std::array<TileEntry, tile_count> entries{};
    HostProgram result;
    for (std::size_t tile = 0; tile < bins.size(); ++tile) {
        const auto count = bins[tile].size();
        if (count > maximum_pass_references || result.reference_count + count > maximum_pass_references)
            throw std::invalid_argument("compiled pass exceeds reference counter capacity");
        result.reference_count += count;
        if (count == 0) continue;
        entries[tile] = {heap.allocate(4ull * count), static_cast<std::uint32_t>(count)};
        const auto offset = static_cast<std::size_t>(entries[tile].address - heap.base);
        for (std::size_t i = 0; i < count; ++i) write_u32(heap.bytes, offset + 4 * i, records.at(bins[tile][i]));
    }
    const auto table = heap.allocate(tile_count * tile_entry_bytes);
    const auto table_offset = static_cast<std::size_t>(table - heap.base);
    for (std::size_t tile = 0; tile < entries.size(); ++tile) {
        write_u32(heap.bytes, table_offset + tile * tile_entry_bytes, entries[tile].address);
        write_u32(heap.bytes, table_offset + tile * tile_entry_bytes + 4, entries[tile].count);
    }
    result.descriptor_address = heap.allocate(pass_descriptor_bytes);
    heap.put(result.descriptor_address, encode_pass_descriptor({pass.target, pass.color_load, pass.depth_load,
        pass.clear_color, pass.clear_depth, table, pass.depth_store, pass.skip_empty_tiles}));
    result.heap_bytes_used = heap.base - heap_base + heap.bytes.size();
    return result;
}

HostProgram encode_program(HostProgram result, const std::vector<Upload>& uploads,
                           std::uint32_t first_sequence) {
    constexpr std::size_t upload_chunk = maximum_upload_decoded_bytes;
    std::uint64_t packet_count = 2;
    for (const auto& upload : uploads) {
        packet_count += (upload.bytes->size() + upload_chunk - 1) / upload_chunk;
        result.upload_bytes += upload.bytes->size();
    }
    if (packet_count > static_cast<std::uint64_t>(std::numeric_limits<std::uint32_t>::max()) - first_sequence)
        throw std::overflow_error("compiled program requires a new sequence epoch");
    auto sequence = first_sequence;
    const auto append = [&](Opcode opcode, const std::vector<std::uint8_t>& payload) {
        auto packet = encode_packet(opcode, sequence++, payload);
        result.bytes.insert(result.bytes.end(), packet.begin(), packet.end());
    };
    for (const auto& upload : uploads) {
        for (std::size_t offset = 0; offset < upload.bytes->size(); offset += upload_chunk) {
            const auto length = std::min(upload_chunk, upload.bytes->size() - offset);
            const std::vector<std::uint8_t> bytes(upload.bytes->begin() + static_cast<std::ptrdiff_t>(offset),
                upload.bytes->begin() + static_cast<std::ptrdiff_t>(offset + length));
            append(Opcode::WriteHeap, encode_heap_upload(
                upload.address + static_cast<std::uint32_t>(offset), bytes));
        }
    }
    std::vector<std::uint8_t> payload(4);
    write_u32(payload, 0, result.descriptor_address); append(Opcode::SubmitPass, payload);
    result.fence_sequence = sequence; result.fence_token = sequence;
    write_u32(payload, 0, result.fence_token); append(Opcode::Fence, payload);
    result.next_sequence = sequence;
    return result;
}

} // namespace

HostProgram compile_pass(const Pass& pass, std::uint32_t first_sequence) {
    require_program(pass, first_sequence);
    HeapBuilder heap;
    std::unordered_map<const Image*, TextureDescriptor> textures;
    std::vector<std::optional<TextureDescriptor>> bindings(pass.primitives.size());
    std::uint64_t texture_bytes = 0;
    for (std::size_t index = 0; index < pass.primitives.size(); ++index) {
        const auto& primitive = pass.primitives[index];
        if (!needs_texture(primitive)) continue;
        const auto image = std::visit([](const auto& item) { return item.state.texture; }, primitive);
        if (!image || !image->texture_compatible()) throw std::invalid_argument("invalid host texture binding");
        const auto found = textures.find(image.get());
        if (found != textures.end()) { bindings[index] = found->second; continue; }
        const auto pixels = texture_pixels(*image);
        const auto address = heap.allocate(pixels->size());
        TextureDescriptor texture{address, static_cast<std::uint32_t>(image->width()),
            static_cast<std::uint32_t>(image->height()), static_cast<std::uint32_t>(image->pitch_bytes())};
        require_texture(texture);
        heap.put(address, *pixels);
        texture_bytes += pixels->size();
        textures.emplace(image.get(), texture);
        bindings[index] = texture;
    }
    auto result = build_pass_heap(pass, bin_primitives(pass.primitives), bindings, heap);
    result.texture_upload_bytes = result.resident_texture_bytes = texture_bytes;
    return encode_program(std::move(result), {{heap.base,
        std::make_shared<const std::vector<std::uint8_t>>(std::move(heap.bytes))}}, first_sequence);
}

struct HostPassCompiler::Impl {
    struct Resident {
        std::shared_ptr<const Image> image;
        TextureDescriptor descriptor;
        std::shared_ptr<const std::vector<std::uint8_t>> pixels;
    };
    std::vector<Resident> residents;
    std::vector<Resident> pending_residents;
    std::uint32_t end = heap_base;
    std::uint32_t pending_end = heap_base;
    bool pending = false;
};

HostPassCompiler::HostPassCompiler() : impl_(std::make_unique<Impl>()) {}
HostPassCompiler::~HostPassCompiler() = default;
HostPassCompiler::HostPassCompiler(HostPassCompiler&&) noexcept = default;
HostPassCompiler& HostPassCompiler::operator=(HostPassCompiler&&) noexcept = default;

HostProgram HostPassCompiler::compile(const Pass& pass, std::uint32_t first_sequence) {
    auto& state = *impl_;
    if (state.pending) throw std::logic_error("complete or reset the outstanding host pass before compiling another");
    require_program(pass, first_sequence);
    const auto bins = bin_primitives(pass.primitives);
    std::uint64_t transient_bytes = pass_descriptor_bytes + tile_count * tile_entry_bytes;
    for (const auto& primitive : pass.primitives) transient_bytes += record_bytes(primitive);
    std::uint64_t references = 0;
    for (const auto& bin : bins) references += bin.size();
    if (references > maximum_pass_references)
        throw std::invalid_argument("compiled pass exceeds reference counter capacity");
    transient_bytes += 4 * references;

    // Exact CPU snapshots prevent hash collisions and mutable aliases from
    // silently retaining stale pixels. The FPGA never sees this host storage.
    std::vector<Impl::Resident> active;
    std::uint64_t active_texture_bytes = 0;
    std::unordered_map<const Image*, std::size_t> images;
    std::vector<std::optional<std::size_t>> primitive_images(pass.primitives.size());
    for (std::size_t index = 0; index < pass.primitives.size(); ++index) {
        const auto& primitive = pass.primitives[index];
        if (!needs_texture(primitive)) continue;
        const auto image = std::visit([](const auto& item) { return item.state.texture; }, primitive);
        if (!image || !image->texture_compatible()) throw std::invalid_argument("invalid host texture binding");
        auto found = images.find(image.get());
        if (found == images.end()) {
            active_texture_bytes += static_cast<std::uint64_t>(image->pitch_bytes()) * image->height();
            if (active_texture_bytes + transient_bytes > memory_bytes - heap_base)
                throw std::invalid_argument("compiled pass exceeds the shared GPU heap");
            found = images.emplace(image.get(), active.size()).first;
            active.push_back({image, {0, static_cast<std::uint32_t>(image->width()),
                static_cast<std::uint32_t>(image->height()), static_cast<std::uint32_t>(image->pitch_bytes())},
                texture_pixels(*image)});
        }
        primitive_images[index] = found->second;
    }
    auto residents = state.residents;
    std::vector<Upload> uploads;
    std::uint64_t end = state.end;
    for (auto& texture : active) {
        const auto found = std::find_if(residents.begin(), residents.end(), [&](const auto& resident) {
            return resident.image.get() == texture.image.get() &&
                resident.descriptor.width == texture.descriptor.width &&
                resident.descriptor.height == texture.descriptor.height &&
                resident.descriptor.pitch_bytes == texture.descriptor.pitch_bytes;
        });
        if (found != residents.end()) {
            texture.descriptor = found->descriptor;
            if (*texture.pixels == *found->pixels) texture.pixels = found->pixels;
            else uploads.push_back({texture.descriptor.base, texture.pixels});
            *found = texture;
        } else {
            texture.descriptor.base = static_cast<std::uint32_t>(end);
            end += texture.pixels->size();
            residents.push_back(texture);
            uploads.push_back({texture.descriptor.base, texture.pixels});
        }
    }
    if (end + transient_bytes > memory_bytes) {
        // Older submissions have completed. Reclaim unused residents and pack
        // active textures again, uploading all moved/retained content explicitly.
        end = heap_base;
        residents.clear(); uploads.clear();
        for (auto& texture : active) {
            texture.descriptor.base = static_cast<std::uint32_t>(end);
            end += texture.pixels->size();
            residents.push_back(texture);
            uploads.push_back({texture.descriptor.base, texture.pixels});
        }
    }
    if (end + transient_bytes > memory_bytes)
        throw std::invalid_argument("compiled pass exceeds the shared GPU heap");
    for (const auto& texture : active) require_texture(texture.descriptor);
    HeapBuilder heap(static_cast<std::uint32_t>(end));
    std::vector<std::optional<TextureDescriptor>> bindings(pass.primitives.size());
    for (std::size_t index = 0; index < bindings.size(); ++index)
        if (primitive_images[index]) bindings[index] = active[*primitive_images[index]].descriptor;
    auto result = build_pass_heap(pass, bins, bindings, heap);
    result.resident_texture_bytes = end - heap_base;
    for (const auto& upload : uploads) result.texture_upload_bytes += upload.bytes->size();
    uploads.push_back({heap.base, std::make_shared<const std::vector<std::uint8_t>>(std::move(heap.bytes))});
    result = encode_program(std::move(result), uploads, first_sequence);
    // Commit only after the caller observes the successful matching fence.
    state.pending_residents = std::move(residents);
    state.pending_end = static_cast<std::uint32_t>(end);
    state.pending = true;
    return result;
}

void HostPassCompiler::complete() {
    auto& state = *impl_;
    if (!state.pending) throw std::logic_error("no outstanding host pass to complete");
    state.residents = std::move(state.pending_residents);
    state.end = state.pending_end;
    state.pending = false;
}
void HostPassCompiler::reset() {
    impl_ = std::make_unique<Impl>();
}

} // namespace nano_gpu::hw
