apc53pro/Nano-20K-GPU/(commit log)

2026-10-23 feat: add tiled software GPU reference renderer
    Establish the M0 architecture and numeric contracts, CPU triangle setup, tiled RGB565/D24 rendering, perspective textures, shading, 2D operations, and logical presentation. Add SDL2 and headless demos, raw frame exports, golden-vector conformance tests, portable SDL setup scripts, and development documentation.
2026-10-23 feat: model Gowin hardware primitives and opaque tile pipeline
    Record the Tang Nano 20K device limits and primary-source primitive configurations. Model signed 18x18 DSP latency and clock enables, synchronous SDPB ports and collision rules, and a bounded opaque tile raster pipeline with explicit setup and memory cycles. Add independent conformance tests, hardware-profile reporting, an SDL/headless opaque demo, block interface documentation, and Windows CI coverage.
    [demo.cpp, demo.hpp, hardware_tests.cpp, hw_bsram.cpp, hw_mult18x18.cpp, hw_tile_pipeline.cpp]
2026-10-24 docs: diagram current GPU pipeline
2026-10-24 feat: trace fragment throughput and map GPU staging RAM
2026-10-26 fix: keep RTL scanout fed during host uploads
    [main.cpp, nano_gpu_core.sv, nano_scanout.sv, native_video_tb.sv]
2026-10-26 Reduce GPU area and qualify logical-core routing
    Share arithmetic, pack retained state into native RAM, and compute exact integer texture coordinates with an 18-edge pipeline. Preserve rendering features and the command ABI while bringing the serial-core probe within the Tang Nano 20K's physical resource limits.
    Add exact-part routing evidence, physical LUT accounting, regression coverage, and updated architecture/control guides. The logical core routes at 20,351 LUT sites but still misses its 100.8 MHz timing target; production board qualification remains open.
2026-10-29 Pipeline GPU control paths and record 68.88 MHz timing estimate
    Break arbitration, recovery, clipping, descriptor validation and fragment backpressure paths while preserving the CPU byte ABI and warm fragment initiation interval of one.
    Retain the source-matched legal serial-probe route at an estimated 68.88 MHz core clock, with pixel-identical full GPU regressions. Update both GPU guides, resource evidence and cycle comparisons; further clock optimization is paused for board integration and measurement.
2026-10-29 Document exact Core2350B to Tang Nano 20K wiring layout
    Reserve sixteen 3.3 V signal GPIOs using all ten existing VGA pins and GP10-GP15. Record verified manufacturer header contacts, FPGA package pins, bank voltages, resistor placement and boot isolation requirements.
    Add a printable three-page A4 wiring guide, both board header locators and a JSON-driven diagram generator. Update both authoritative GPU guides. Firmware, RTL, FPGA constraints and the retained timing candidate are unchanged.
2026-11-01 Measure lossless upload decoder cost and preserve failed GPU fit evidence
    [gpu_codec_probe.sv, nano_upload_word_decoder.sv, nano_upload_word_decoder_tb.sv, traffic.cpp, traffic_tb.sv]
2026-11-01 Replace heap uploads with one shared lossless ABI 0.2 engine
    [gpu_control_docs_harness.c, host_link_tests.cpp, hw_host_link.cpp, hw_protocol.cpp, hw_system.cpp, main.cpp, nano_gpu_core.sv]
2026-11-06 Integrate Tang Nano 20K board target and programming image
2026-11-06 Update Core2350B wiring guides for GP35-GP40 remap
2026-11-06 Document initial MPC-2350 GPIO terminal driver
2026-11-06 Document FPGA configuration wait and invalid-bus probes
2026-11-06 Document Arduino GPIO transport and capability preflight
2026-11-06 Use a 6.3 MHz fixed GPU bus-test image and document slow host timing
    [generate-core2350b-tang-nano20k-wiring.py, main.cpp, nano_gpu_core.sv]
2026-11-07 Document held-read measurements and the address-latch diagnostics
    A confirmed held read of register 0x41 measured RVALID HIGH, WREADY LOW
    and all eight Tang data pins at 0 V, so the GPU answered with 0x00
    instead of 0x02. With the one-edge register-01 answer, this indicates
    the FPGA latched a different capability-range address. Address-write
    acceptance cannot show this because address-phase WREADY is !gpu_d[7].
    Document the MPC-2350 GPU_LATCHTEST reset-and-read sequence and the
    edge-free GPU_DRIVE address-phase hold, plus the cold power-up FF
    result from configuration finishing after the 1000 ms allowance. No
    FPGA RTL, constraint or image changes.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
2026-11-07 Isolate the host address-latch fault to the open-source FPGA build
    The open-flow GPU image latches wrong host addresses on the board, while
    every other part of the bus is cleared:
    - GPU_DRIVE 55/2A delivered every RP data bit to its constrained Tang pin.
    - A gate-level simulation of the synthesized netlist passes the firmware
    sequences.
    - A pin-identical bus-echo diagnostic image (experiments/bus-echo), built
    by the same open flow, echoed every address and drove HIGH data back.
    - The unchanged tang20k_top RTL built with Gowin EDA
    (experiments/gowin-ab) reached READY with correct latch, capability and
    status reads.
    The fault lies after synthesis (packing, placement or bitstream
    gener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
    [build.py, bus_echo_tb.sv, tang20k_bus_echo.sv]
2026-11-07 Restore 50.4 MHz GPU video with a Gowin-built image and burst copies
    - Return the board to the 50.4 MHz core/SDRAM, 25.2 MHz pixel profile.
    - Close core timing in Gowin: retime the UV multipliers (same 3-edge
    latency) and add a copy-init prep state.
    - Replace per-pixel COPY_RECT with 16-word SDRAM burst copies through a
    row RAM, with realignment for odd pixel phase and per-word strobes.
    - Build the board image with Gowin EDA; the open-source flow's image failed
    its host address latch on the board. AGENTS.md records the temporary
    exception for the unverified Gowin install and encrypted netlist.
    - Publish the image (SHA-256 55ebdfbd...) with its timing, pin, structural
    and functional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
    [build.py, main.cpp, nano_gpu_core.sv, sdram_model.cpp, tang20k_board_tb.sv]
2026-11-07 Document the MPC-2350 PIO and NARM GPU driver
2026-11-07 Pin GPU guides to the published firmware
2026-11-07 Burst tile LOAD/STORE, empty-tile skipping and depth DISCARD
    Every pass loaded and stored all 300 tiles, and LOAD fetched color and
    depth one SDRAM word per pixel, so an empty preserve-color pass took
    580 ms on the 50.4 MHz board profile. Tile transfers now move 16-word
    bursts per tile row; STORE streams depth at one word per clock and
    RGB565 at one word per two clocks. A tile without draws writes only its
    stored clears as constant bursts, so a LOAD-color pass skips it.
    Pass load-flag bit 2 (depth DISCARD) keeps depth pass-local: it is
    cleared or loaded and tested but never written back, and the external
    depth attachment becomes invalid. Flat triangles skip the plane offset
    walk. The render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
    [hw_protocol.cpp, hw_system.cpp, hw_tile_pipeline.cpp, main.cpp, nano_gpu_core.sv, nano_tile_renderer.sv, protocol_tests.cpp]
2026-11-07 Document the exact build and programming tools; add flash targets
    The Education IDE's bundled programmer_cli (1.9.8.11) detects the
    Tang's SPI flash but fails every flash operation and leaves the FPGA
    unconfigured. Only the signed standalone Gowin Programmer V1.9.12.04
    writes the flash. The control guide now names each tool and its path,
    the expected status codes and the failure signatures, and
    make tang20k-flash / tang20k-sram / tang20k-status run the right
    programmer with the hash check and PYTHONIOENCODING cleared.
    Record that image a249064f... was written to flash and verified on
    2026-11-07 and reloaded with user code 0x3354; RP2350 rendering on it
    is not yet reported.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
2026-11-07 Pipeline SDRAM bursts, widen the scanout FIFO, clear tiles during stores
    Profiling the board-profile core showed the SDRAM service dominating:
    every BL8 segment paid CHOOSE/PREPARE/CAS bubbles, writes staged a whole
    request before any burst, and scanout drained each refill one pixel per
    edge while owning the service (about 40% of SDRAM time).
    - nano_sdram_service: column commands issue eight edges apart when the
    row is open, so reads and writes stream back to back; a WRITE segment
    issues once its own words are staged while later ones keep filling;
    writes retire with their last beat (tWR enforced per bank); turnaround
    only separates opposite directions; the next segment's PRECHARGE o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
    [main.cpp, nano_gpu_core.sv, nano_scanout.sv, nano_sdram_service.sv, nano_tile_renderer.sv, sdram_accept_check_tb.sv]
2026-11-08 Record that the SDRAM-pipeline image is flashed and verified
    Image 3fc16700... was written to the Tang's SPI flash with the signed
    Gowin Programmer V1.9.12.04 (program and verify succeeded) and the FPGA
    reloaded it with status 0x6020, user code 0xE7A9. Rendering with the
    RP2350 on this image is not yet reported.
2026-11-08 Document the host startup retry for late FPGA configuration
    At cold power-up the FPGA can finish configuring after the fixed 1000 ms
    allowance, so the first boot read all FF and stayed offline. The RP
    firmware now treats the allowance as a minimum: until the immutable
    capability prefix answers, it re-pulses GPU_RESET_N and retries every
    100 ms for up to 10 s, and it starts the sequence only after the final
    system-clock change. Record the behaviour, its mock coverage and the
    user's 2026-11-08 report that a full power cycle now connects.
2026-11-08 Add the SKIP pass flag: leave tiles without draws untouched
    On the board, demo_3d_engine6 spent 12.6 ms of each frame on the GPU,
    about 70% of it writing all 300 tiles back to SDRAM although the
    icosahedron covers about 70 of them.
    Load-flag bit 3 (SKIP) makes the executor leave every tile without
    references untouched, even in a clearing pass. Tiles with references
    clear or load, draw and store as before. Because untouched tiles keep
    their contents, SKIP requires a valid target color (fault 5 otherwise,
    as for a color LOAD), and stored depth stays valid only if it was
    valid before. Hosts list the tiles drawn now plus the tiles that may
    still hold earlier drawing; an empty-scissor rectangle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
    [hw_protocol.cpp, hw_system.cpp, hw_tile_pipeline.cpp, main.cpp, nano_gpu_core.sv, protocol_tests.cpp, reference.hpp]
2026-11-08 Record the SKIP image's 60 fps board result and the async present fault
    The user ran demo_3d_engine6 (draw SDK with SKIP, blocking present, no
    frame sleep) on image 5b6f75aa at a stable 60 fps without faults. The
    firmware's asynchronous present path loses one PRESENT reply byte on the
    board; the software-model client test of that call order passes, and the
    cause is not yet isolated.
2026-11-08 Document MMBasic frame batching and async reply polling
2026-11-09 Add GPU triangle setup: 64-byte kind-4 vertex triangles
    The RP2350 spent most of demo_3d_engine9's 5 fps frame preparing
    320-byte triangle records (64-bit depth planes, edges, exact binning)
    and sending them: about 106 ms of CPU and 63 ms of binning and bus per
    frame, against 34 ms of GPU work.
    Record kind 4 carries only three Q4 vertices (14/13-bit fields, so a
    right/bottom guard band), three D24*256 depths, a drawing rectangle
    that acts as a scissor, flags, color and a cull bit. For each tile
    reference, nano_triangle_setup intersects the rectangle with the tile,
    forms the signed area, culls or negates the edges of a negative area,
    computes C, rejects tiles no pixel center can cover, deriv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
2026-11-09 Record flashing the GPU triangle-setup image
    make tang20k-flash wrote image 93739598... to the Tang's SPI flash;
    program and verify succeeded and the FPGA reloaded it with status
    0x6020, user code 0xB6B9. It is not yet tested with the RP2350.
2026-11-09 Document pipelined host writes and MC10's binary32 triangle setup
    The MPC-2350 firmware's new write_block keeps up to eight data-register
    writes in the PIO FIFOs instead of one CPU round trip per byte; PIO still
    samples WREADY before every write edge, the 250 ms deadline runs from the
    last completed byte, and address selects and reads are unchanged. This is
    a local firmware change, not yet run on the board.
    MC10 Build 44 deliberately replaces the exact rational plane equations for
    its textured world triangles with a binary32 setup shared per clipped
    face (exact depth cross products, integer depth seed extrapolation), so
    its frames are not bit-identical to the reference oracle. Its test boun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
2026-11-10 Document DMA host writes, pipelined frames and demo9 board timings
    The MPC-2350 firmware now feeds packet bytes to the unchanged PIO bus
    program by DMA; on the board the demo's upload phase fell from 8.9 to
    5.4 ms. Record the PIO program's real write rate (about 27 cycles per
    byte, not one byte per HCLK), the pipelined frame order that in-order
    execution allows, and the first on-board frame breakdown of
    demo_3d_engine9: 30.2 ms GPU render, consistent with the 28.2 ms replay.
2026-11-10 Document burst host writes: one byte per HCLK edge
    The MPC-2350 PIO program now sends every write as a counted burst with
    WR_N held LOW, so the FPGA takes one byte per HCLK rising edge (12 PIO
    cycles instead of about 27), still gated by WREADY before each edge. On
    the board, demo_3d_engine9's upload phase went from 5.4 to 4.6 ms at
    18.75 MHz; the GPU's packet leases and upload decoding are the likely
    remaining limit (not yet measured).
2026-11-12 Release SDRAM commands early and overlap tile stores
    Profiling showed tile stores dominated by per-transaction overhead: every
    16-word transfer waited for the previous transaction to retire before its
    grant, check and row activation, and scanout refills took about 40% of
    SDRAM time during stores.
    The service now releases its command slot once a transaction's last column
    command has issued. Two 16-word payload slots (previously unused words of
    the same RAM banks) let the next transaction stage while the previous
    write's beats or read response finish. Each slot frees on its own
    completion event; the beat run and the response stream keep their owner and
    slot. Direction interlocks keep released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
    [nano_gpu_core.sv, nano_scanout.sv, nano_sdram_service.sv, sdram_accept_check_tb.sv, sdram_arbiter_tb.sv]
2026-11-13 Record flashing the early-release GPU image
    make tang20k-flash wrote image ecc7030b... to the Tang's SPI flash with
    the signed standalone Gowin Programmer V1.9.12.04; program and verify
    succeeded and the FPGA reloaded it with status 0x6020, user code 0x16D1.
    It is not yet tested with the RP2350.
    Gowin EDA V1.9.11.03 Education is now installed and Authenticode-signed
    by Gowin, which ends the AGENTS.md toolchain exception: the image must be
    rebuilt with it and re-qualified.
2026-11-13 Add triangle row exit and overlapped PRESENT; build with signed Gowin EDA
    Row exit: an edge whose x step is <= 0 never improves to the right, so
    once a sample fails it the rest of the row is outside. The renderer then
    ends the row: one ROW_SKIP clock reads the dy coefficients and takes the
    ordinary row step from the saved row start (triangles only, at least two
    samples left). Oracle-checked benchmark: empty samples roughly halve;
    showcase 89.26 -> 86.32 ms, icosahedron 10.53 -> 10.00 ms, 400 kind-4
    triangles 148.8 -> 134.5 ms, new close-up sphere case 23.95 -> 22.04 ms.
    Overflow in skipped samples can no longer fault a pass.
    Overlapped PRESENT: the executor accepts a valid PRESENT at once,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
    [main.cpp, nano_gpu_core.sv, nano_tile_renderer.sv]
2026-11-13 Fix timing for both Gowin versions; keep V1.9.8.11, the faster one
    Five internal timing fixes remove the paths that failed in Gowin EDA
    V1.9.11.03 and limited V1.9.8.11:
    - WREADY's packet-byte term uses a registered address-is-zero flag and a
    register-only host readiness (host_wr_ready_base);
    - the host link keeps "no host error" as its own register;
    - each COPY clipping step registers its candidate before the compare
    (about 8 more setup clocks per COPY);
    - the SDRAM payload/mask read address is computed separately for column
    commands and the beat run, with a simulation check against the old one;
    - a row-exit sample still takes its X step, so the plane and edge register
    enables never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
    [nano_gpu_core.sv, nano_host_link.sv, nano_host_link_tb.sv, nano_sdram_service.sv, nano_tile_renderer.sv, tang20k_core_stub.sv, tang20k_top.sv]
2026-11-13 Record flashing the row-exit and overlapped-PRESENT image
    Image 39fc7dd6...1730 was written to the Tang's SPI flash with
    make tang20k-flash (signed Programmer V1.9.12.04); the FPGA reloaded it
    with status 0x6020 and user code 0x04A2. Not yet tested with the RP2350.
